Alashed/cubesat-wiki/docs/wiki/source/index.rst

.. CubeSat 1U Educational Kit documentation master file, created by
   sphinx-quickstart on Tue Apr 28 01:24:46 2026.
   You can adapt this file completely to your liking, but it should at least
   contain the root `toctree` directive.

Wiki образовательного набора CubeSat 1U
=======================================

Добро пожаловать в документацию по образовательному набору CubeSat 1U.
Этот проект помогает понять, как устроен малый спутник, как его собрать,
подключить и запрограммировать.

.. toctree::
   :maxdepth: 2
   :caption: Разделы

   what-is-cubesat
   kit-components
   assembly-guide
   wiring-diagram
   code-examples
   useful-links
