Alashed/cubesat-wiki/docs/wiki/source/useful-links.rst

Полезные ссылки
===============

В этом разделе собраны внешние материалы, которые могут пригодиться при
сборке, программировании и эксплуатации учебного CubeSat.

Схемы и сборка
--------------

- `Схема подключения CubeSat (Fritzing) на Google Drive
  <https://drive.google.com/drive/folders/1IPIubZdzvfppYFJH4a8wJ_4OlUEUYcYG?usp=sharing>`_
  — исходные файлы Fritzing, по которым построены схемы из инструкции
  по сборке.
