Alashed/cubesat-wiki/docs/wiki/source/_static/besprovodnoy-modul-nrf24l01-24-ggts-1.png

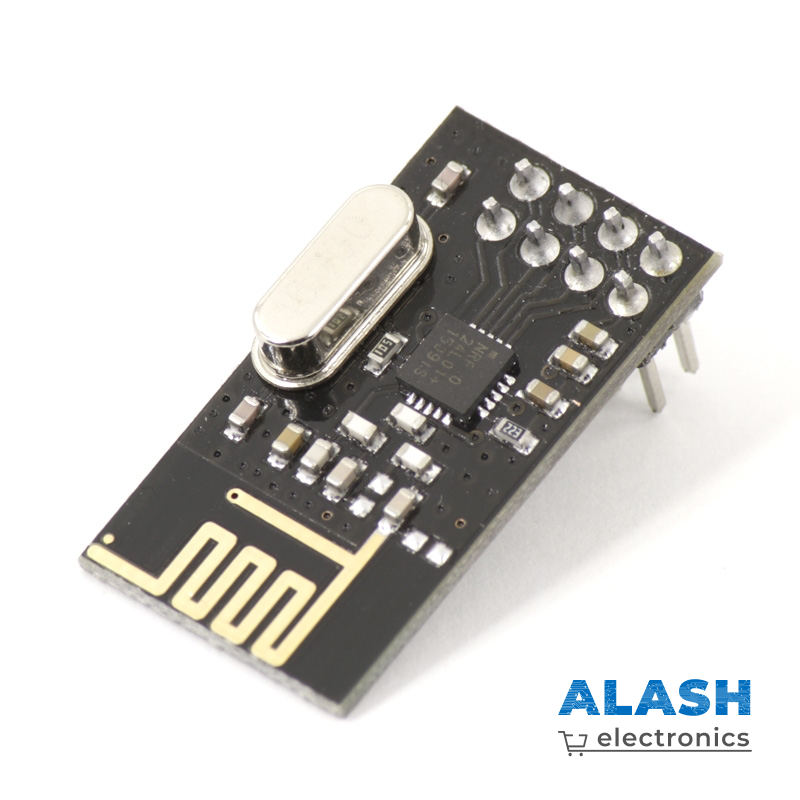
docs/wiki/source/_static/besprovodnoy-modul-nrf24l01-24-ggts-1.png
