Alashed/cubesat-wiki/docs/wiki/source/kit-components.rst

Состав набора CubeSat 1U
========================

На этой странице приведен полный состав образовательного набора в формате
таблицы для комплектации.

Таблица комплектации (изображение, название, количество)
--------------------------------------------------------

.. list-table::
   :header-rows: 1
   :widths: 30 55 15

   * - Изображение
     - Название компонента
     - Кол-во
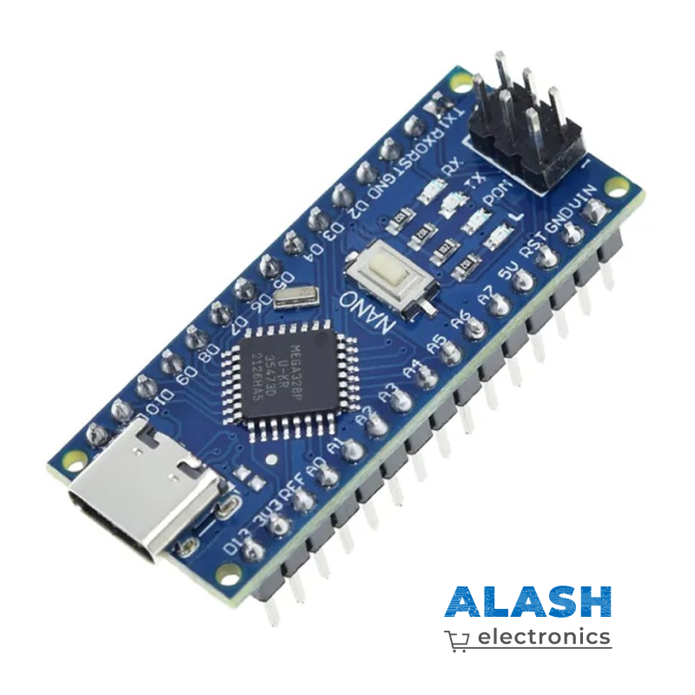
[picture p10: docs/wiki/source/_static/arduino-nano-v30-type-c-ch340-1.png]
Arduino Nano
   * - 
     - Микроконтроллер Arduino Nano
     - 1
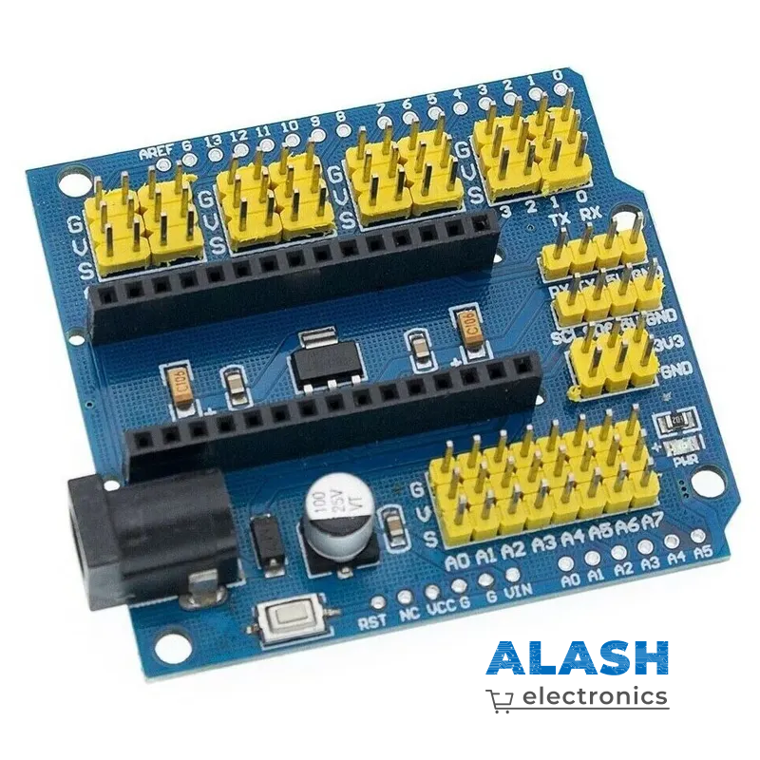
[picture p11: docs/wiki/source/_static/arduino-nano-shield-plata-rasshireniya-dlya-arduino-nano-1.png]
Arduino Nano Shield
   * - 
     - Плата расширения Arduino Nano Shield
     - 1
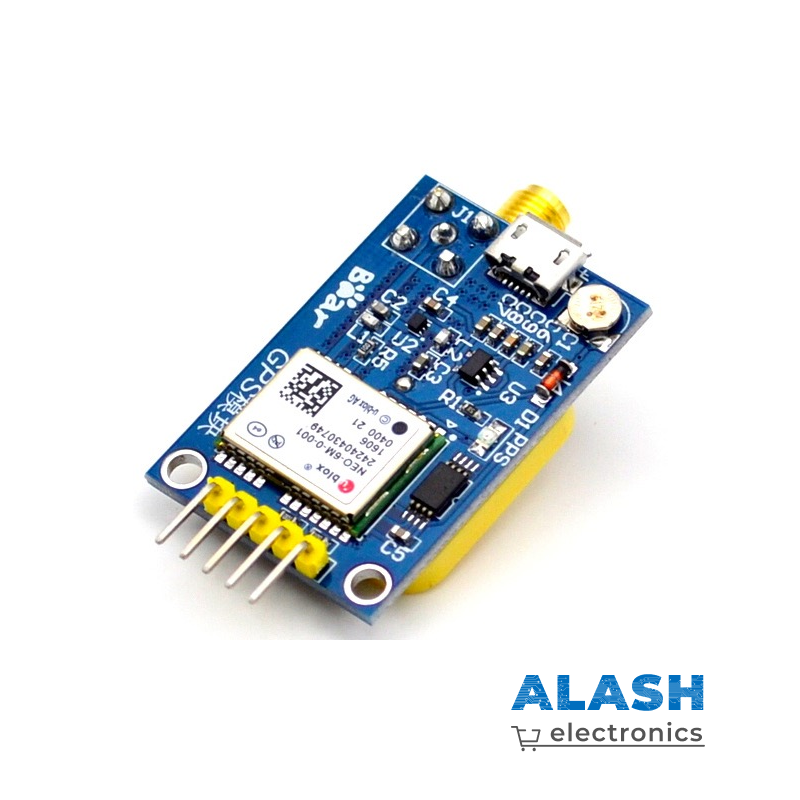
[picture p12: docs/wiki/source/_static/gps-modul-gy-neo-6m-sma-micro-usb-1.png]
GPS GY-NEO-6M
   * - 
     - GPS-модуль GY-NEO-6M (SMA, micro USB)
     - 1
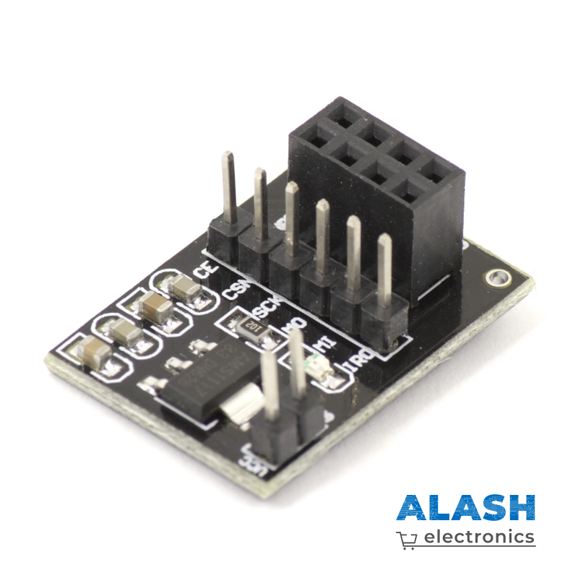
[picture p13: docs/wiki/source/_static/perehodnik-dlya-nrf24l01-33-v-1.png]
Питание для nRF24L01+
   * - 
     - Внешний модуль питания для nRF24L01+
     - 2
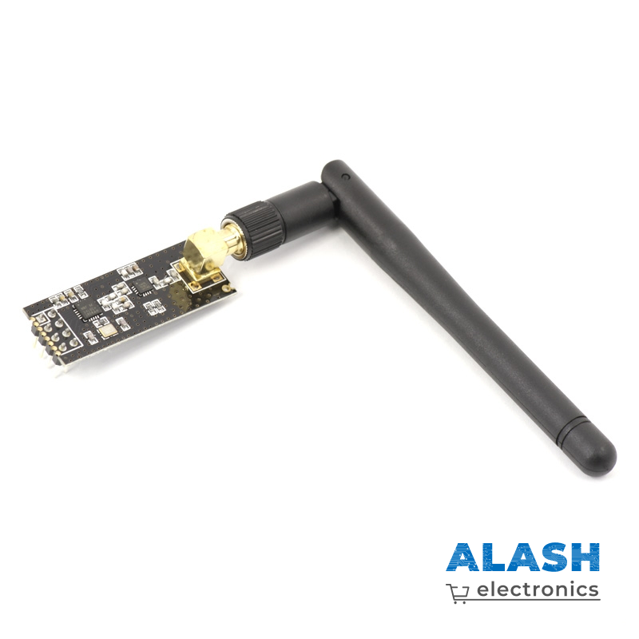
[picture p14: docs/wiki/source/_static/besprovodnoy-modul-nrf24l01palna-s-vneshney-sma-antennoy-1.png]
nRF24L01+ с антенной
   * - 
     - nRF24L01+ с антенной
     - 1
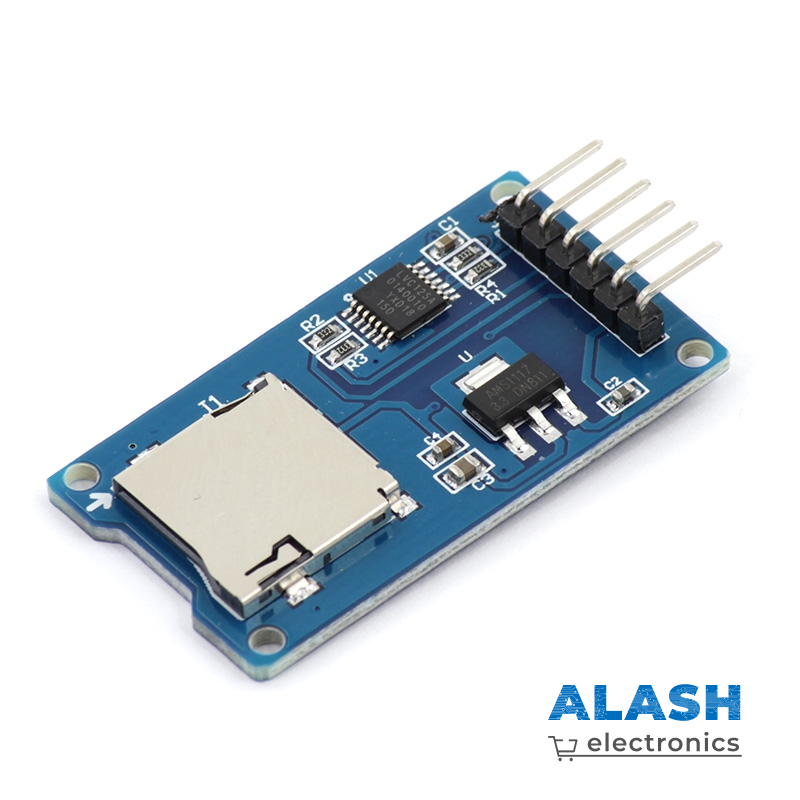
[picture p15: docs/wiki/source/_static/modul-kartrider-karty-pamyati-micro-sd-1.png]
SD модуль
   * - 
     - Модуль microSD (SD Card Module SPI)
     - 1
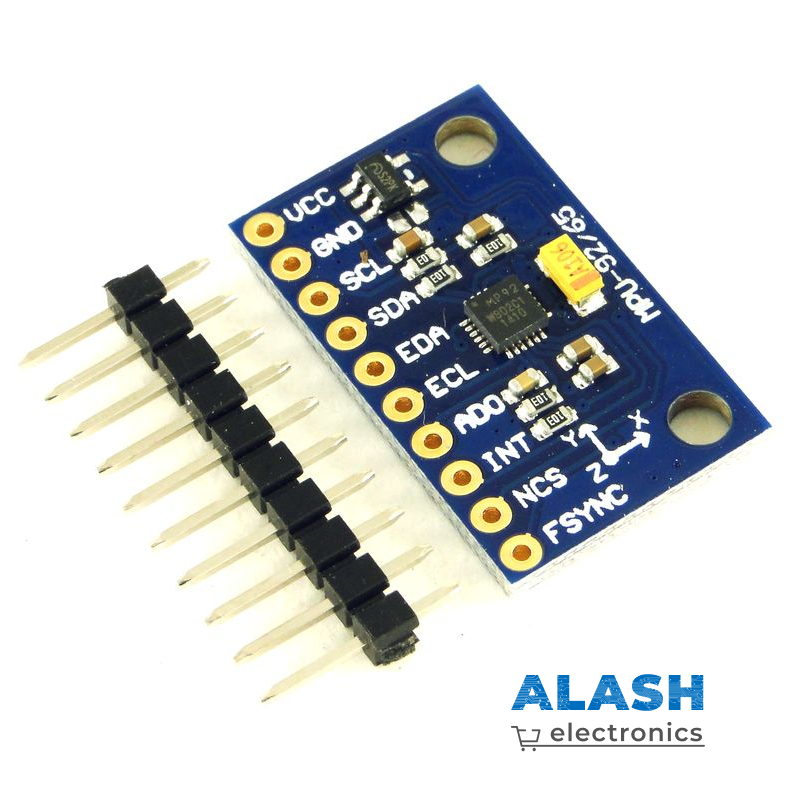
[picture p16: docs/wiki/source/_static/9-osevoy-datchik-mpu-9250-elektronnyy-kompas-akselerometr-giroskop-1.png]
MPU9250
   * - 
     - IMU-модуль MPU9250
     - 1
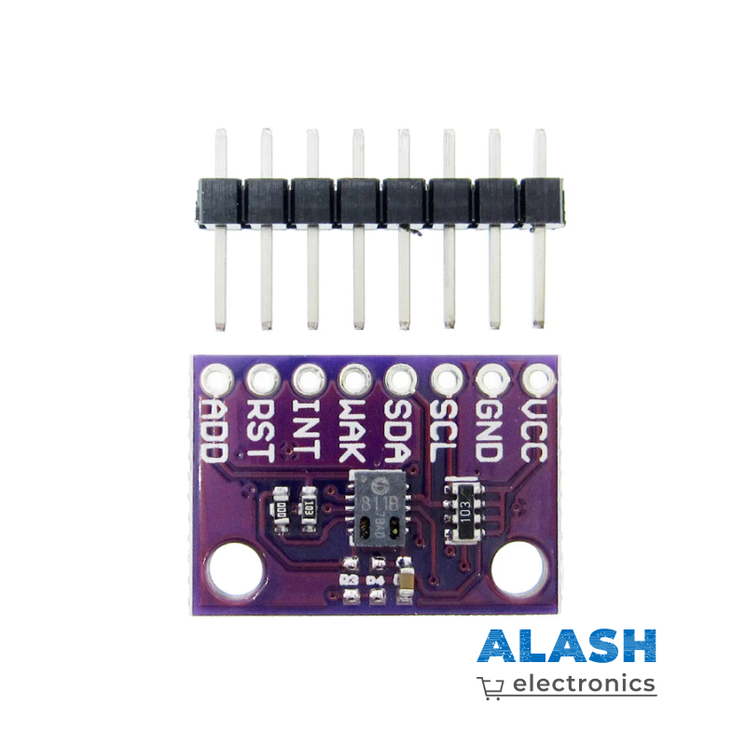
[picture p17: docs/wiki/source/_static/datchik-modul-datchika-obnaruzheniya-uglekislogo-gaza-ccs811-modul-co2-eco2-tvoc-opredelenie-kachestva-vozduha-vyhod-i2c-cjmcu-811-1.png]
CCS811
   * - 
     - Датчик газа CCS811
     - 1
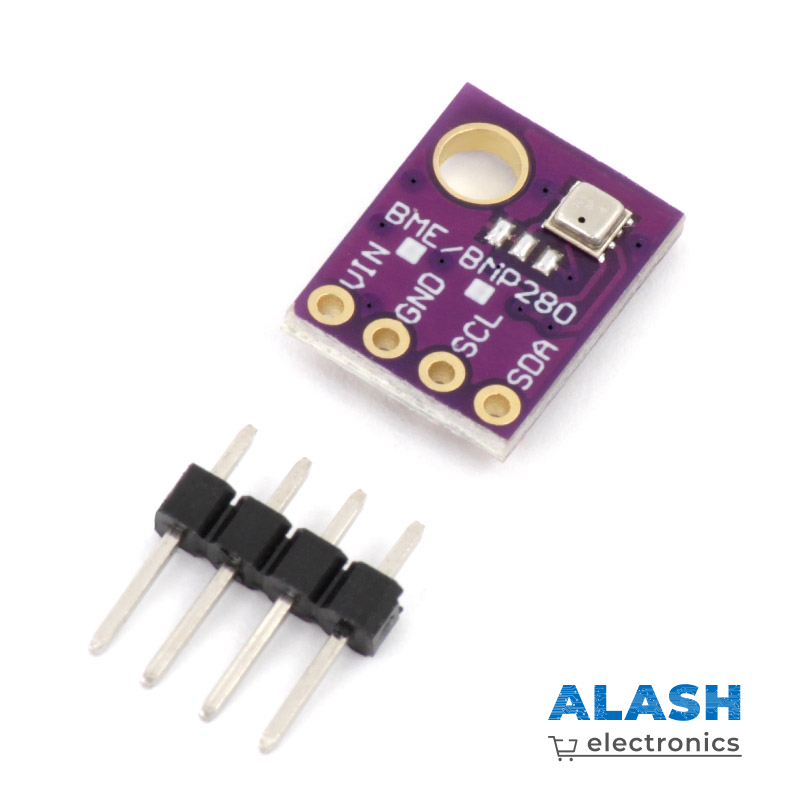
[picture p18: docs/wiki/source/_static/datchik-temperatury-vlazhnosti-i-davleniya-bme280-2.png]
BME280
   * - 
     - Барометрический датчик BME280
     - 1
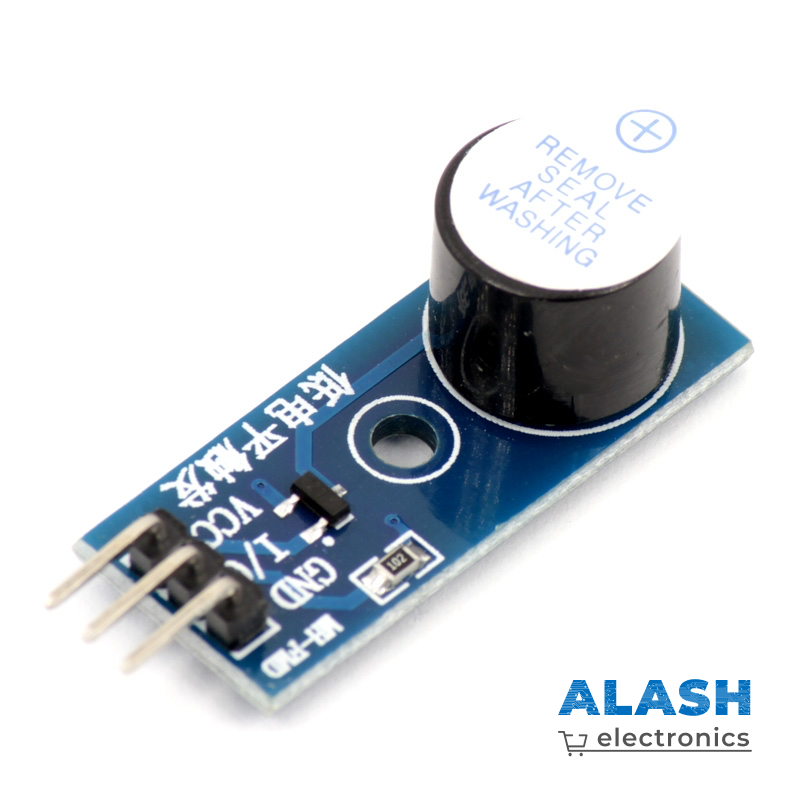
[picture p19: docs/wiki/source/_static/modul-aktivnogo-zummera-1.png]
Buzzer
   * - 
     - Звуковой модуль (Buzzer Module)
     - 1
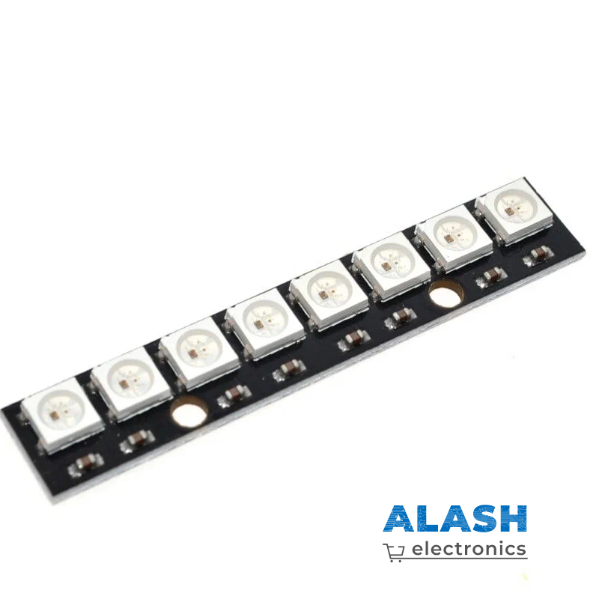
[picture p20: docs/wiki/source/_static/poloska-rgb-svetodiodov-ws2812b-8-sht-1.png]
LED лента
   * - 
     - Адресная LED-лента
     - 1
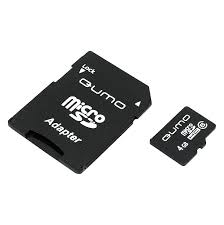
[picture p21: docs/wiki/source/_static/sd-card.jpeg]
Карта microSD
   * - 
     - Карта памяти microSD
     - 1
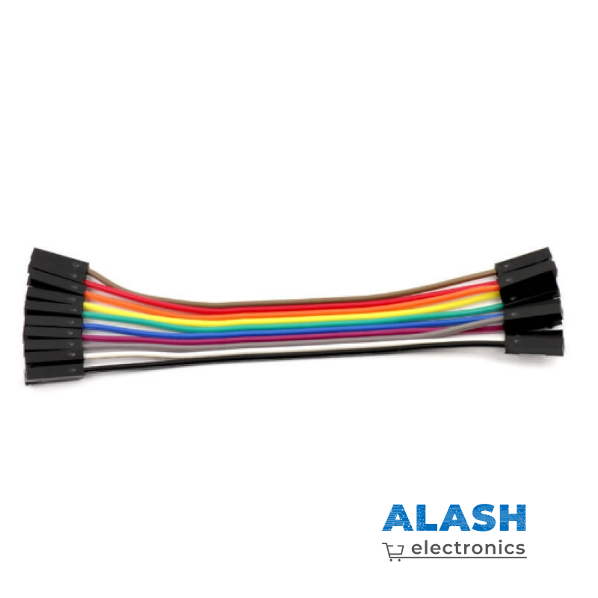
[picture p22: docs/wiki/source/_static/soedinitelnye-provoda-mama-mama-10-sm-10-sht-1.png]
Соединительные провода
   * - 
     - Соединительные провода Dupont / монтажные провода
     - 20+
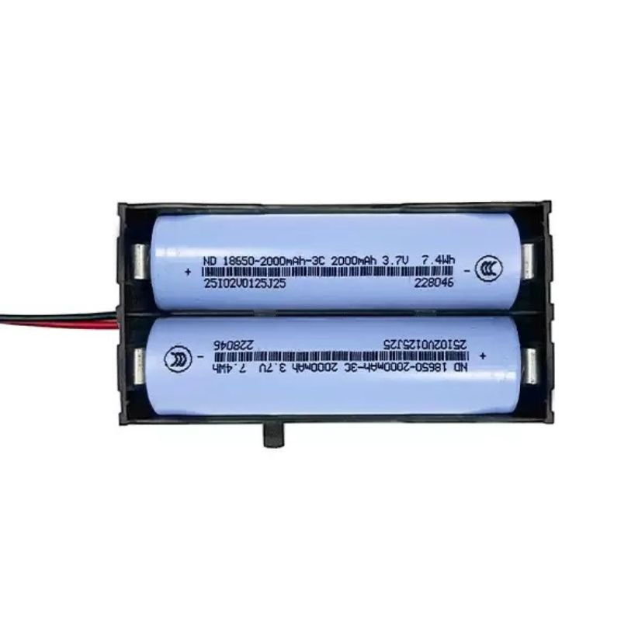
[picture p23: docs/wiki/source/_static/power-source.jpg]
Источник питания
   * - 
     - Источник питания (батарейный блок)
     - 1
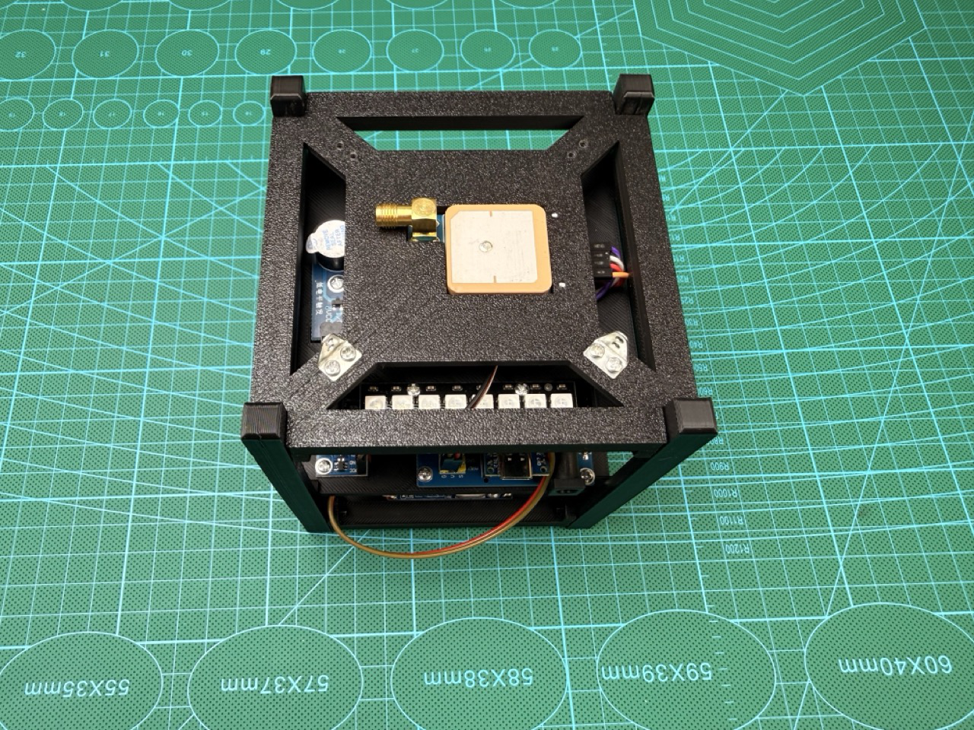
[picture p24: docs/wiki/source/_static/50.jpeg]
Корпус CubeSat 1U
   * - 
     - 3D-печатный корпус 1U CubeSat
     - 1
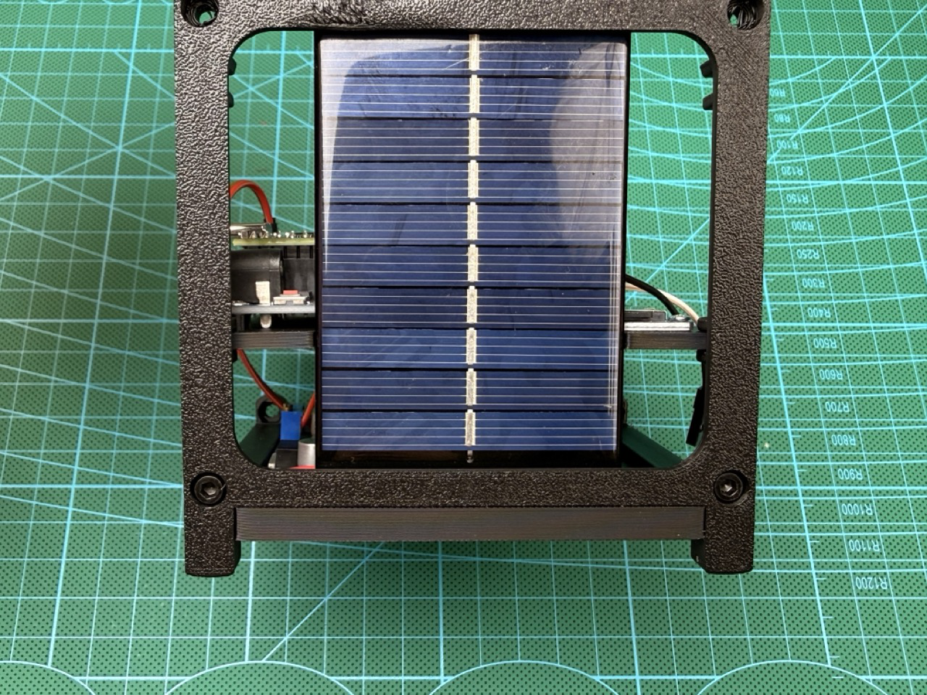
[picture p25: docs/wiki/source/_static/24.jpeg]
Солнечная панель
   * - 
     - Солнечная панель
     - 2
