Alashed/cubesat-wiki/docs/wiki/source/assembly-guide.rst

Инструкция по сборке CubeSat
============================

Перед началом
-------------

1. Проверьте комплектность всех модулей и крепежа.
2. Подготовьте рабочее место без статического электричества.
3. Убедитесь, что питание отключено перед монтажом.

Шаги сборки
-----------

1. Соберите механический каркас 1U.
2. Установите модуль питания и аккумулятор.
3. Закрепите бортовой компьютер и интерфейсные платы.
4. Подключите датчики и модуль связи.
5. Проверьте полярность и надежность всех соединений.
6. Выполните первое включение в безопасном режиме.

Фото-инструкция по сборке (шаги 1-51)
-------------------------------------

.. note::

   Перед физическими шагами 26, 35 и 44 добавлены схемы подключения. На них
   для удобства показаны **только те компоненты, которые подключаются по
   текущему и ближайшим шагам инструкции**, без уже смонтированных ранее
   модулей. Это помогает не запутаться в проводах.

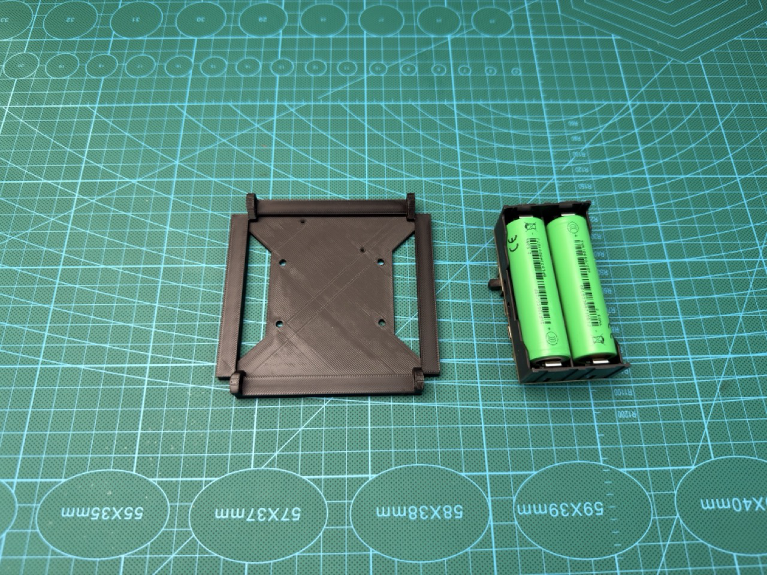
[picture p28: docs/wiki/source/_static/1.jpeg]
Шаг сборки 1


   Шаг 1.

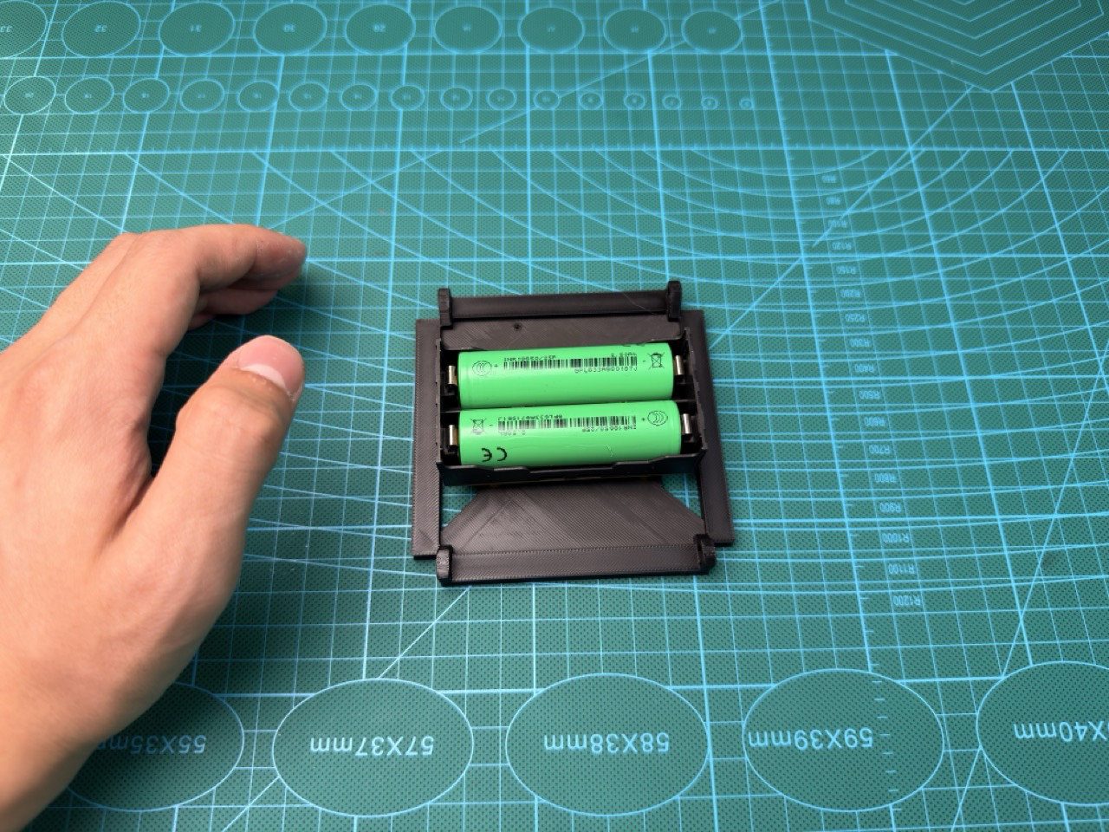
[picture p29: docs/wiki/source/_static/2.jpeg]
Шаг сборки 2


   Шаг 2.

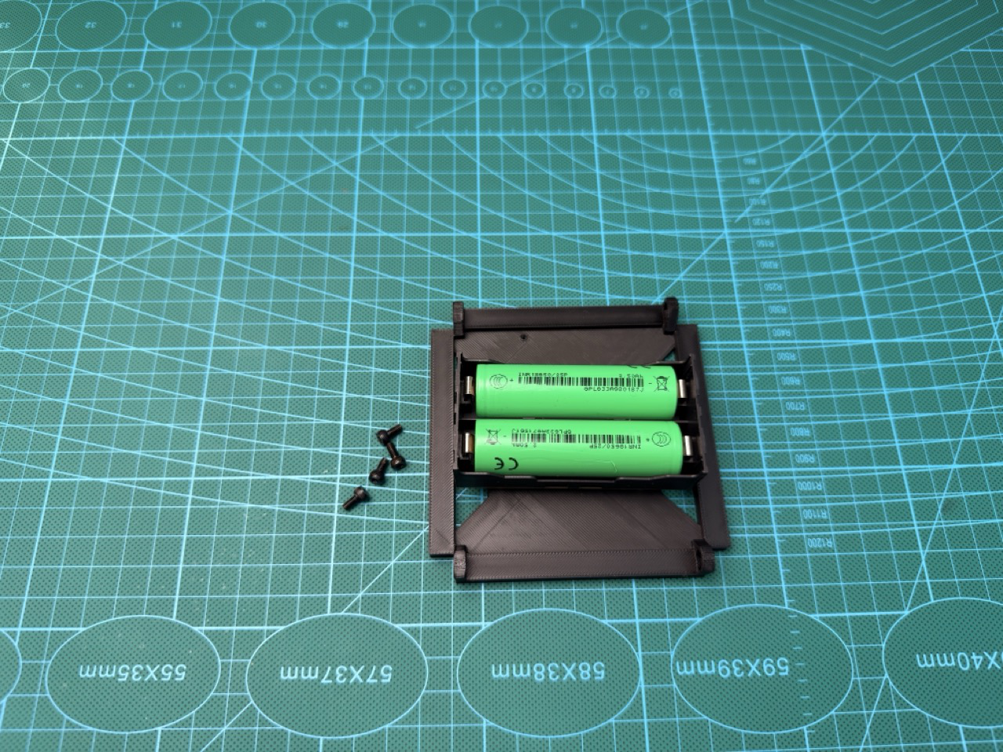
[picture p30: docs/wiki/source/_static/3.jpeg]
Шаг сборки 3


   Шаг 3.

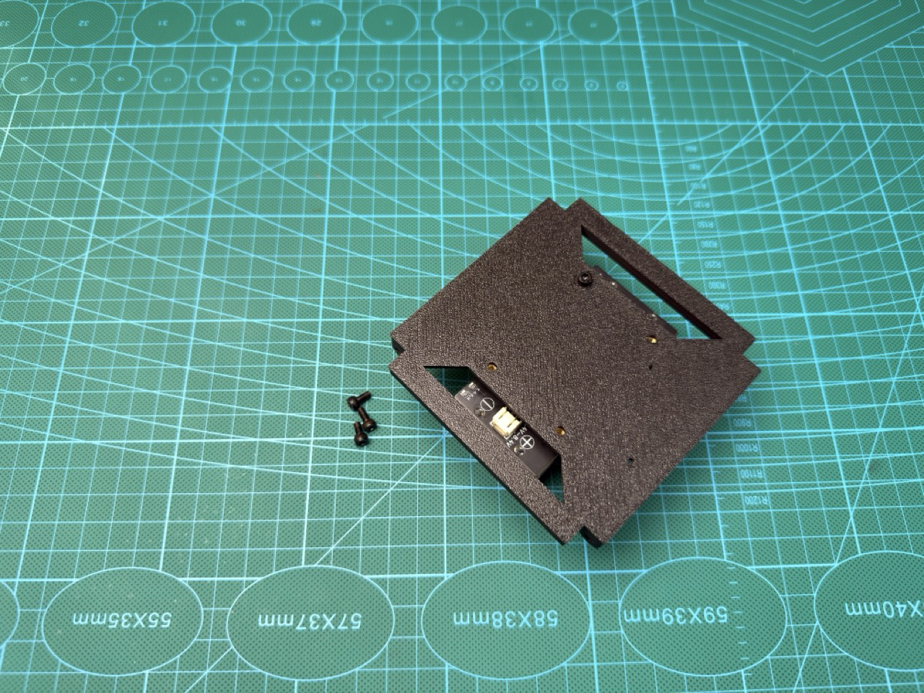
[picture p31: docs/wiki/source/_static/4.jpeg]
Шаг сборки 4


   Шаг 4.

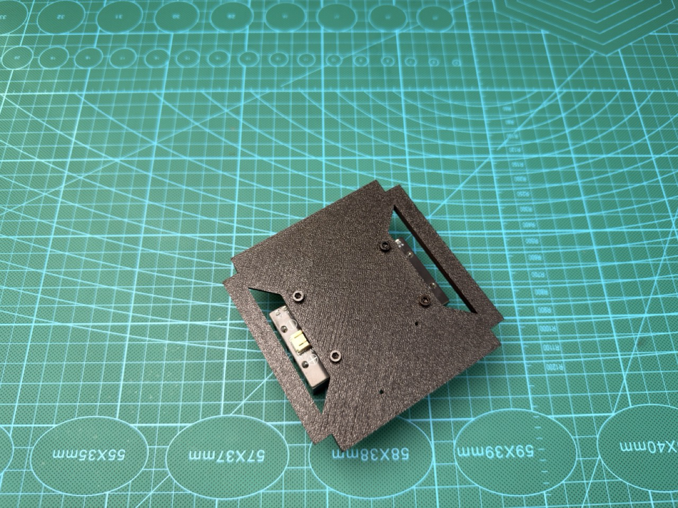
[picture p32: docs/wiki/source/_static/5.jpeg]
Шаг сборки 5


   Шаг 5.

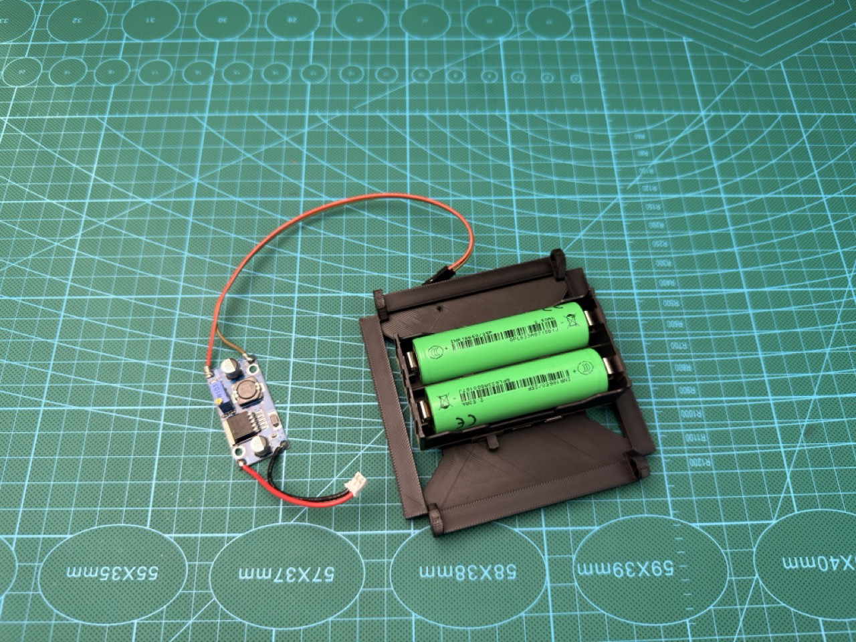
[picture p33: docs/wiki/source/_static/6.jpeg]
Шаг сборки 6


   Шаг 6.

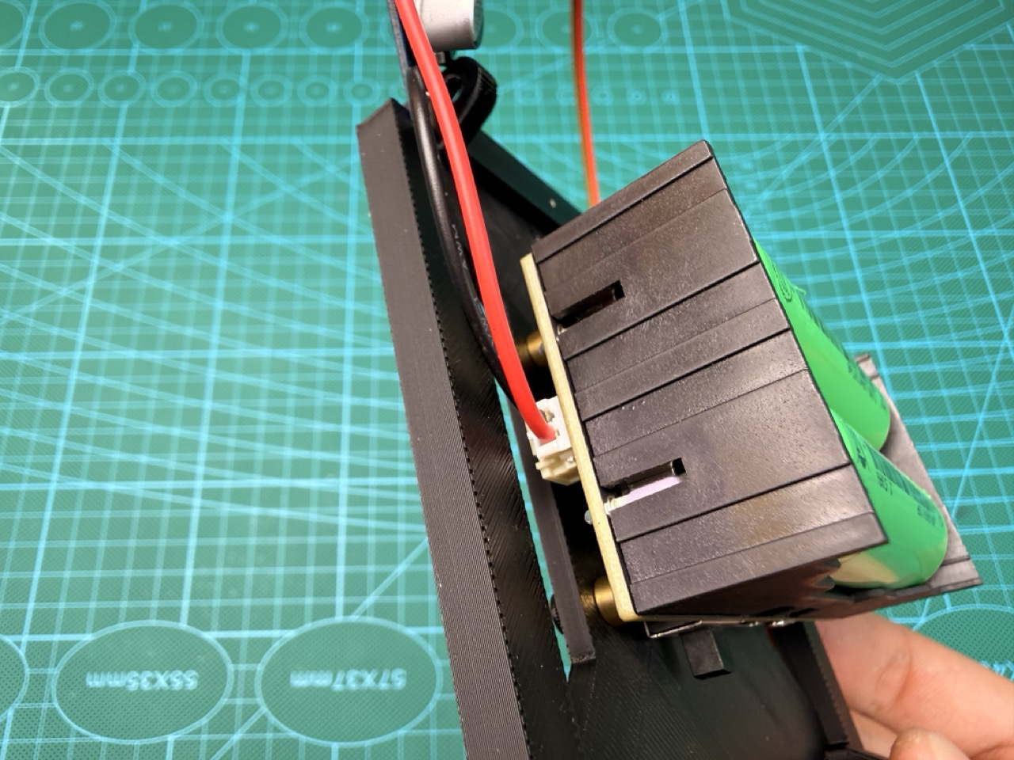
[picture p34: docs/wiki/source/_static/7.jpeg]
Шаг сборки 7


   Шаг 7.

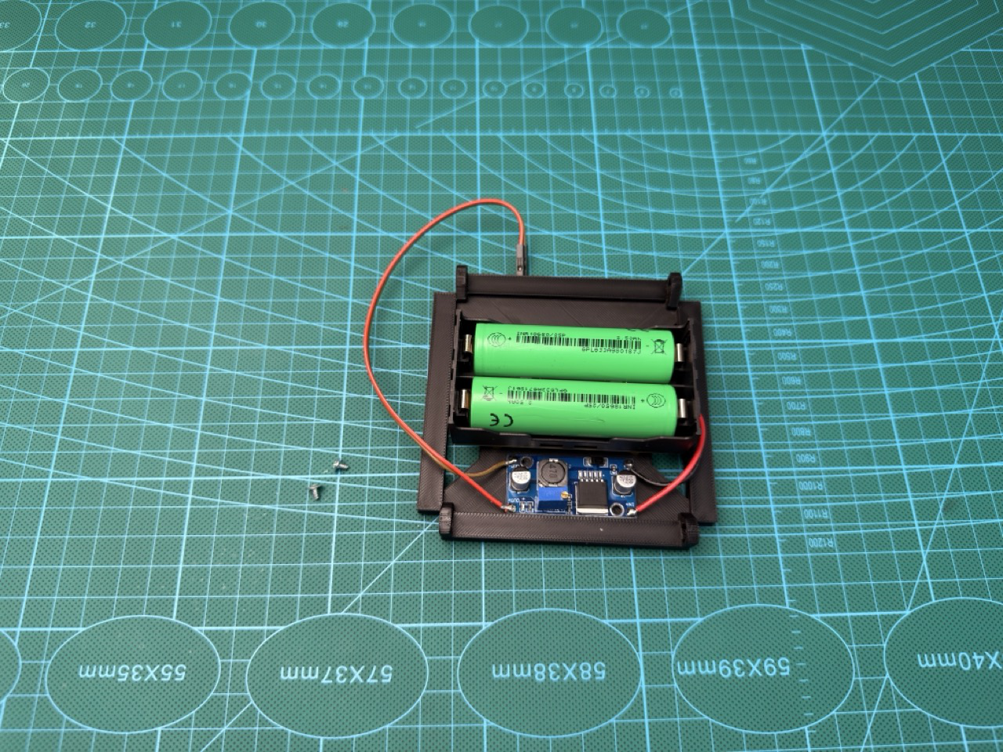
[picture p35: docs/wiki/source/_static/8.jpeg]
Шаг сборки 8


   Шаг 8.

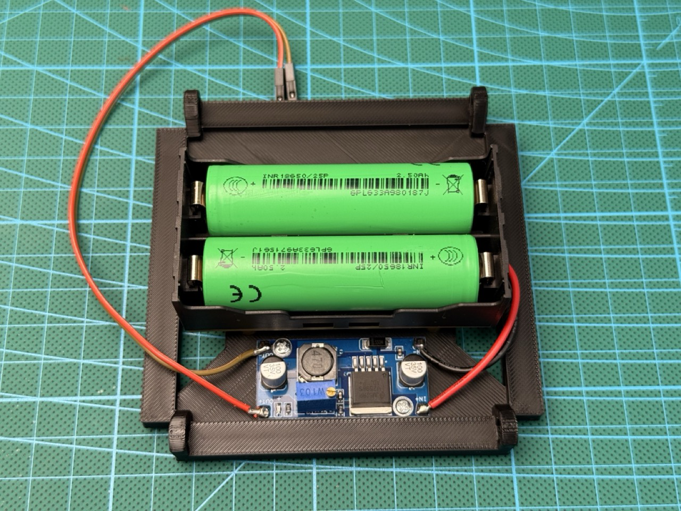
[picture p36: docs/wiki/source/_static/9.jpeg]
Шаг сборки 9


   Шаг 9.

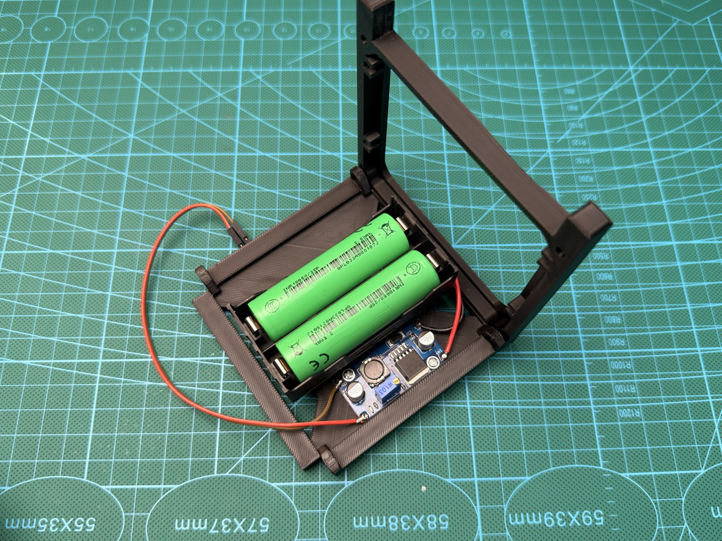
[picture p37: docs/wiki/source/_static/10.jpeg]
Шаг сборки 10


   Шаг 10.

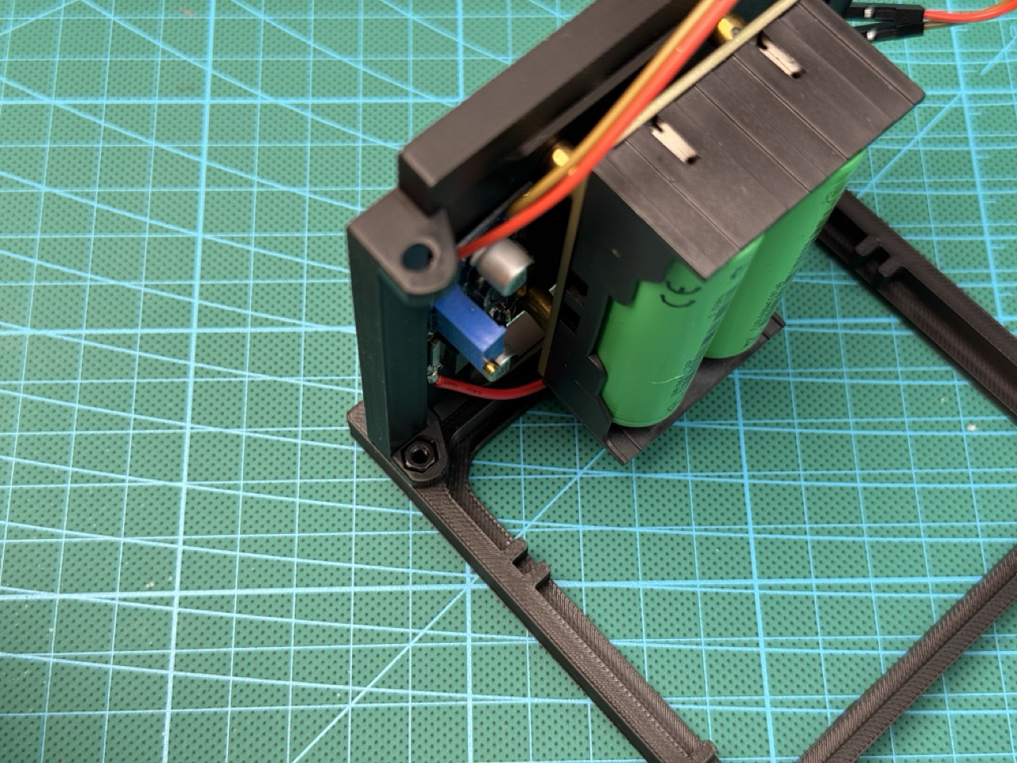
[picture p38: docs/wiki/source/_static/11.jpeg]
Шаг сборки 11


   Шаг 11.

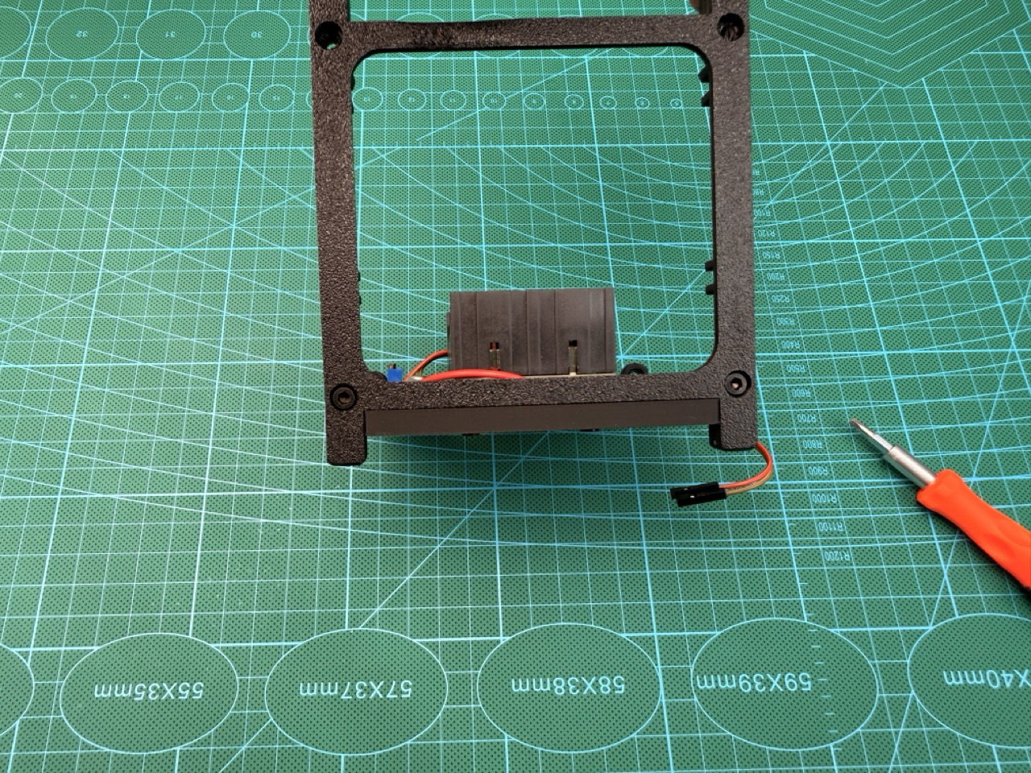
[picture p39: docs/wiki/source/_static/12.jpeg]
Шаг сборки 12


   Шаг 12.

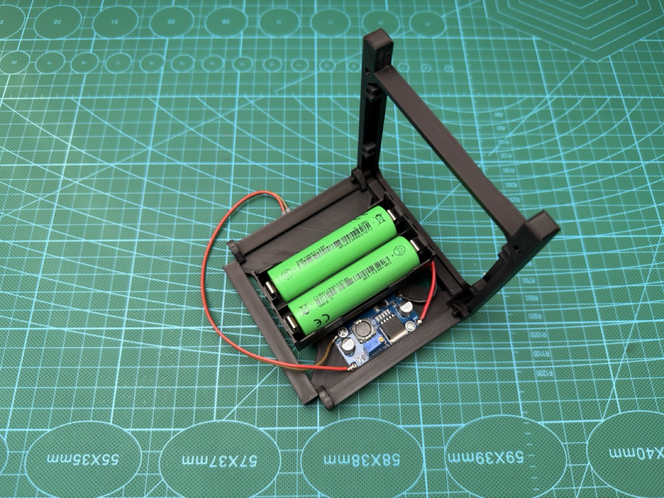
[picture p40: docs/wiki/source/_static/13.jpeg]
Шаг сборки 13


   Шаг 13.

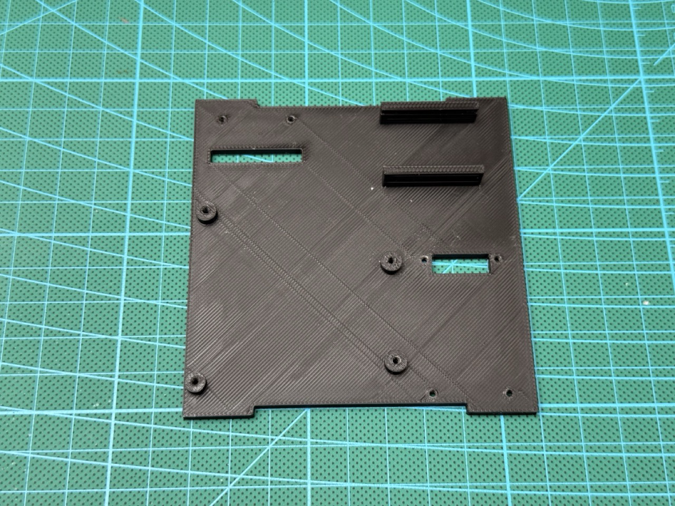
[picture p41: docs/wiki/source/_static/14.jpeg]
Шаг сборки 14


   Шаг 14.

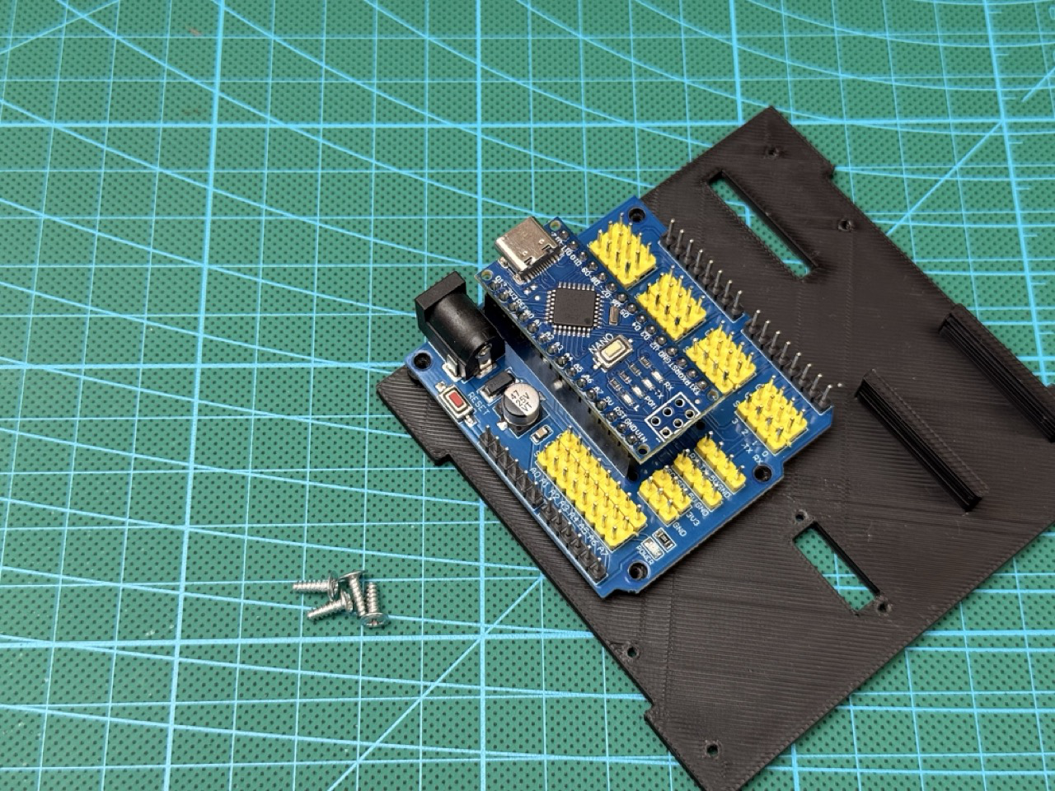
[picture p42: docs/wiki/source/_static/15.jpeg]
Шаг сборки 15


   Шаг 15.

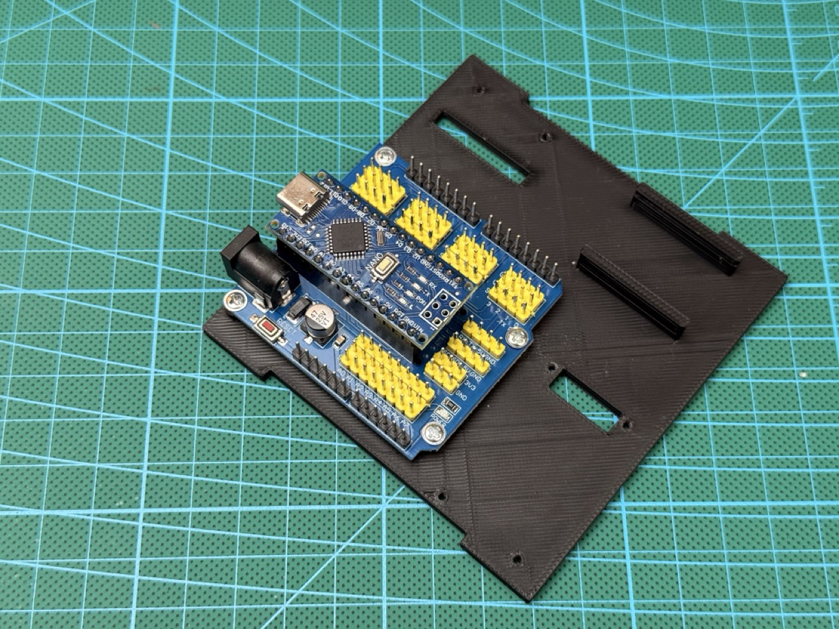
[picture p43: docs/wiki/source/_static/16.jpeg]
Шаг сборки 16


   Шаг 16.

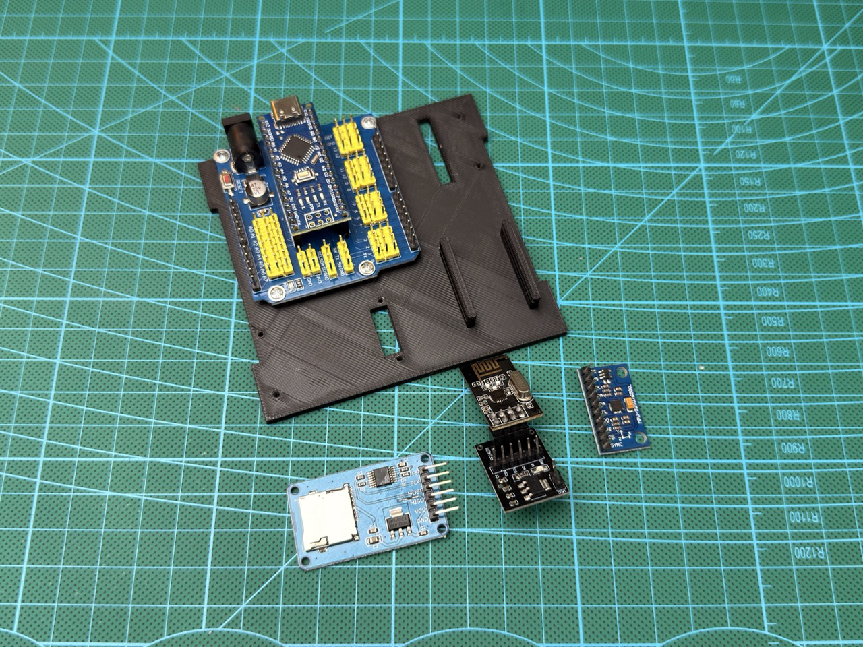
[picture p44: docs/wiki/source/_static/17.jpeg]
Шаг сборки 17


   Шаг 17.

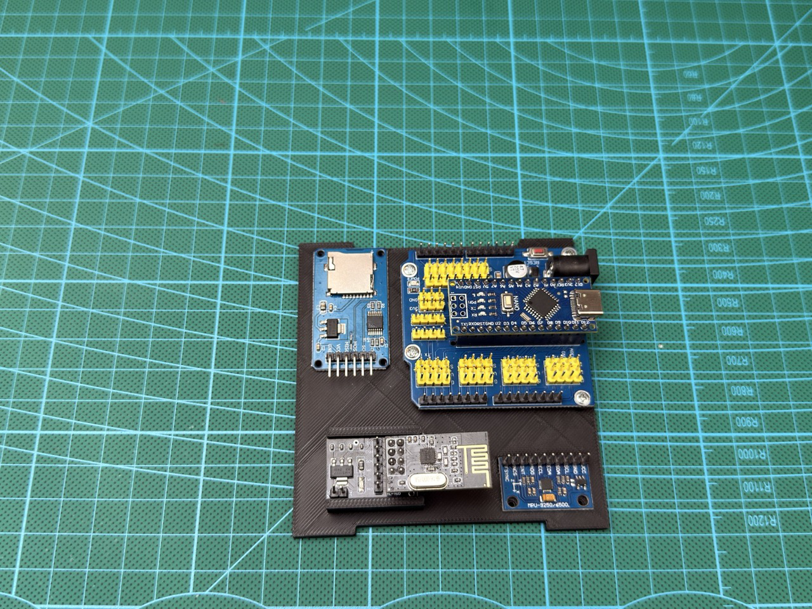
[picture p45: docs/wiki/source/_static/18.jpeg]
Шаг сборки 18


   Шаг 18.

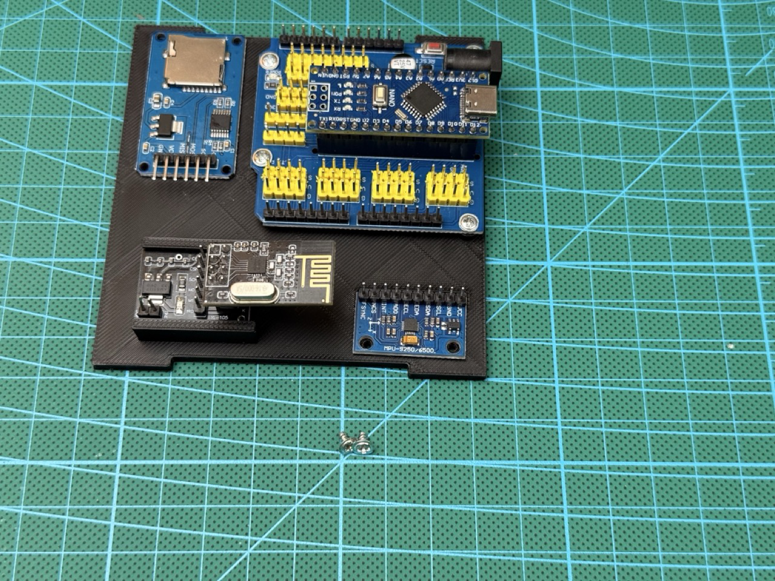
[picture p46: docs/wiki/source/_static/19.jpeg]
Шаг сборки 19


   Шаг 19.

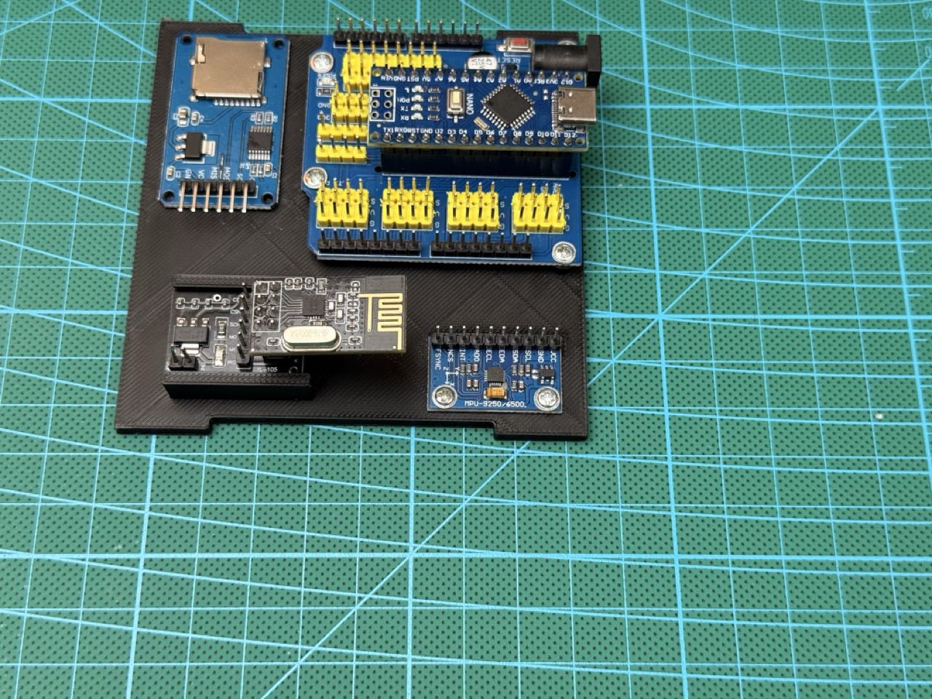
[picture p47: docs/wiki/source/_static/20.jpeg]
Шаг сборки 20


   Шаг 20.

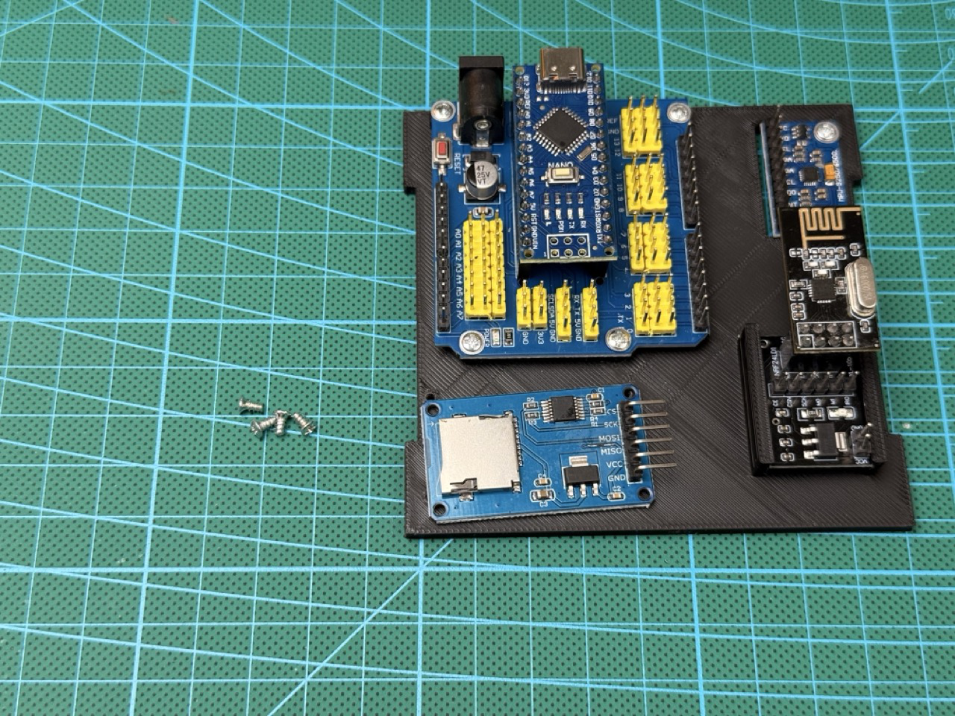
[picture p48: docs/wiki/source/_static/21.jpeg]
Шаг сборки 21


   Шаг 21.

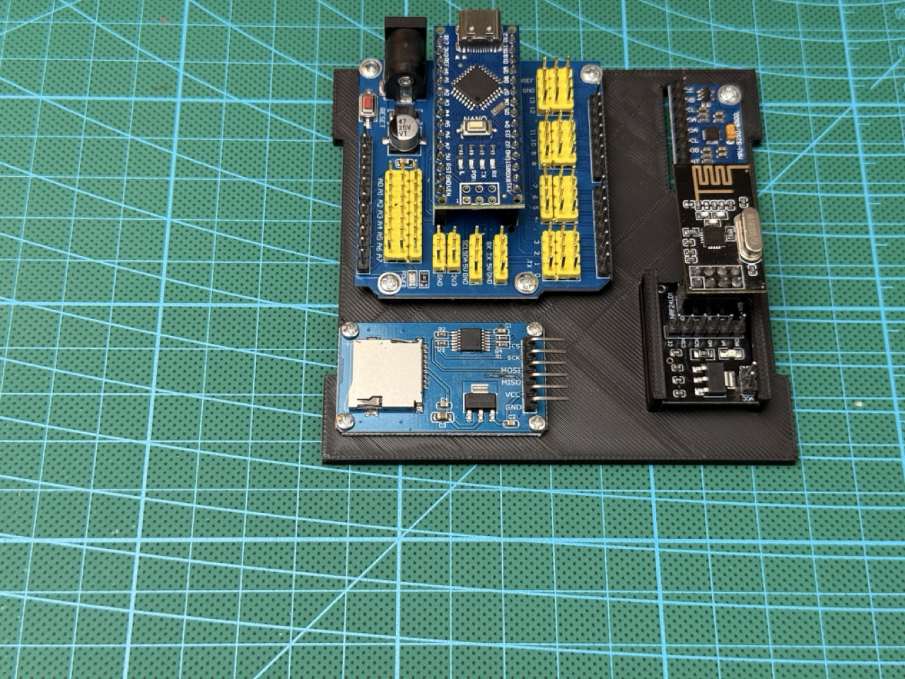
[picture p49: docs/wiki/source/_static/22.jpeg]
Шаг сборки 22


   Шаг 22.

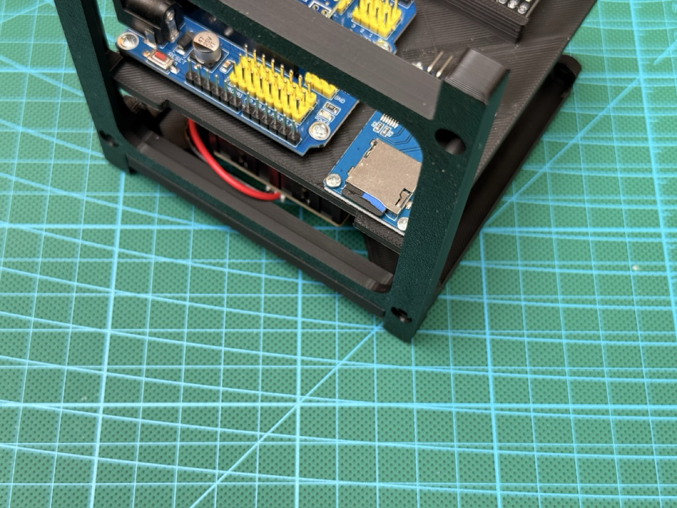
[picture p50: docs/wiki/source/_static/23.jpeg]
Шаг сборки 23


   Шаг 23.

Шаг сборки 24

   Шаг 24.

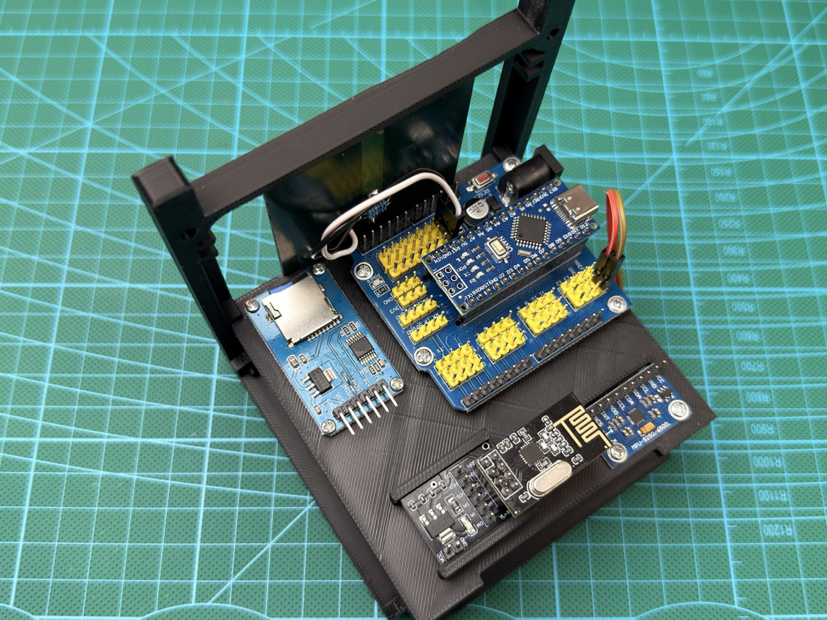
[picture p51: docs/wiki/source/_static/25.jpeg]
Шаг сборки 25


   Шаг 25.

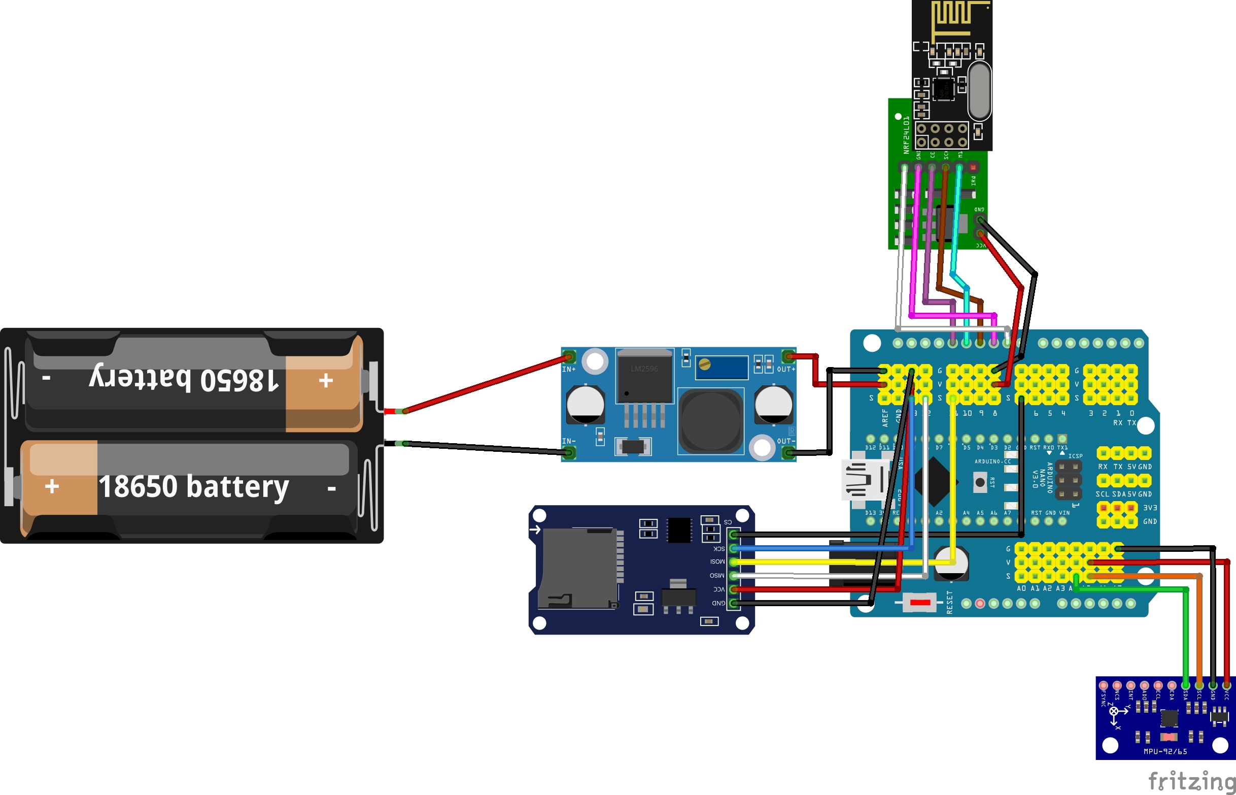
[picture p52: docs/wiki/source/_static/CubeSat-scheme-step-26.jpg]
Шаг сборки 26 — схема подключения


   Шаг 26. Схема подключения модулей (см. примечание выше).

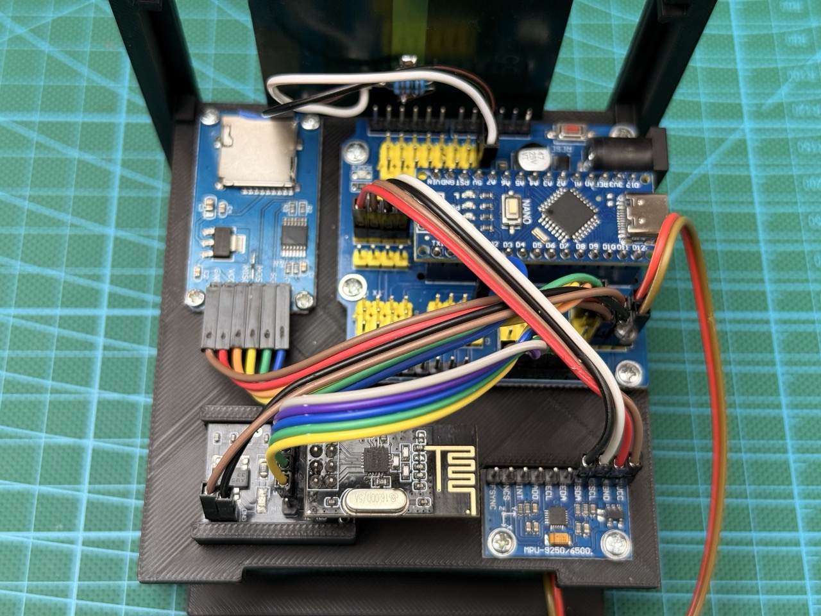
[picture p53: docs/wiki/source/_static/27.jpeg]
Шаг сборки 27


   Шаг 27.

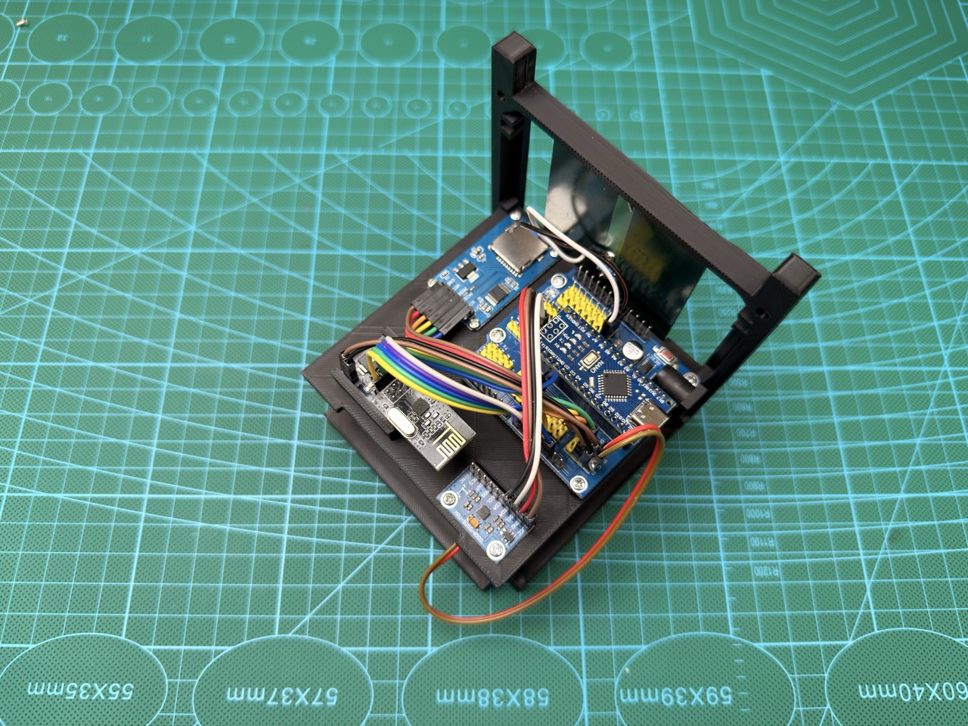
[picture p54: docs/wiki/source/_static/28.jpeg]
Шаг сборки 28


   Шаг 28.

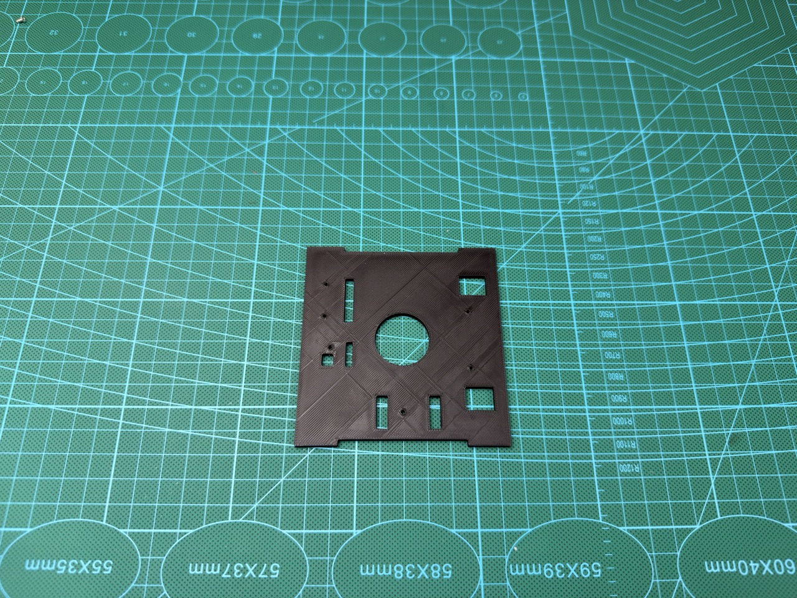
[picture p55: docs/wiki/source/_static/29.jpeg]
Шаг сборки 29


   Шаг 29.

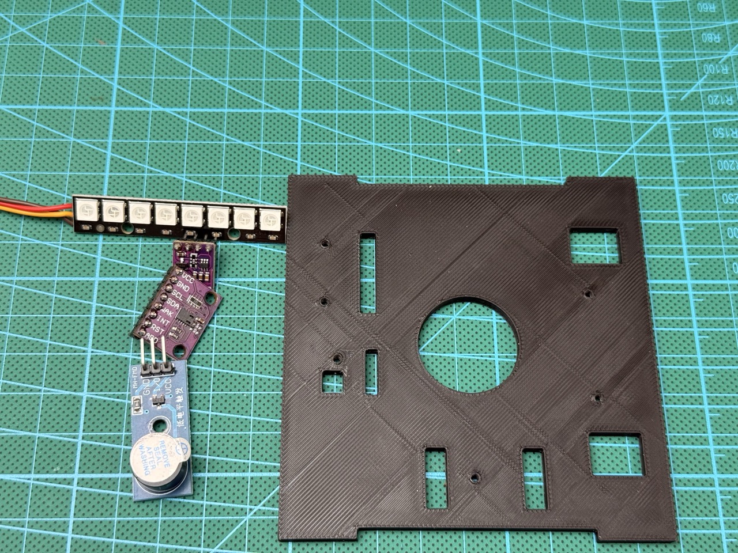
[picture p56: docs/wiki/source/_static/30.jpeg]
Шаг сборки 30


   Шаг 30.

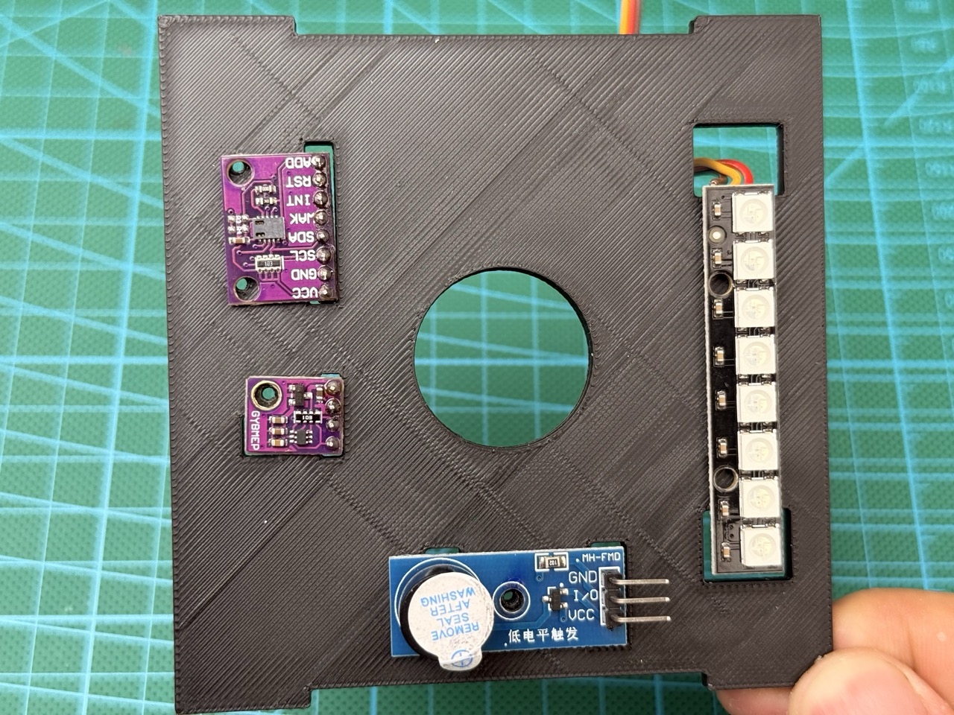
[picture p57: docs/wiki/source/_static/31.jpeg]
Шаг сборки 31


   Шаг 31.

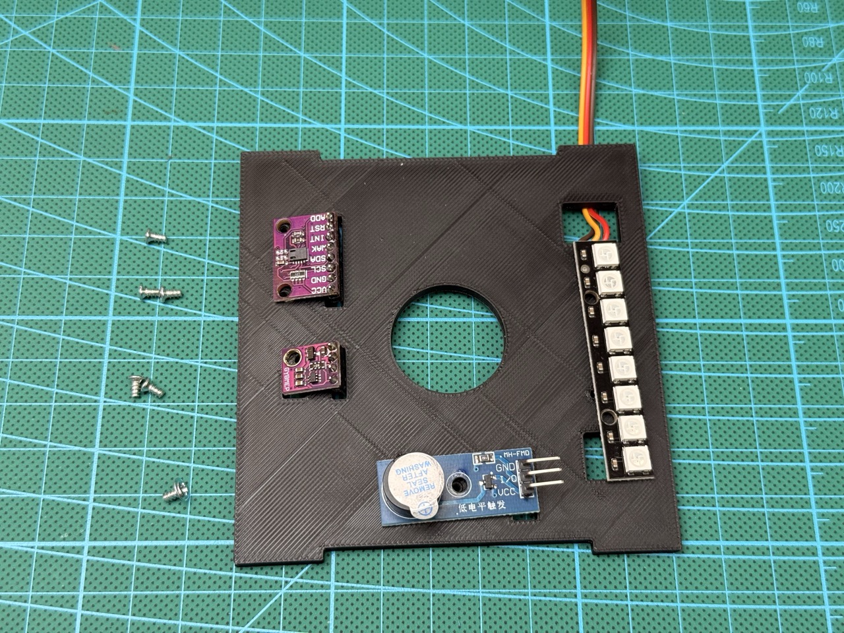
[picture p58: docs/wiki/source/_static/32.jpeg]
Шаг сборки 32


   Шаг 32.

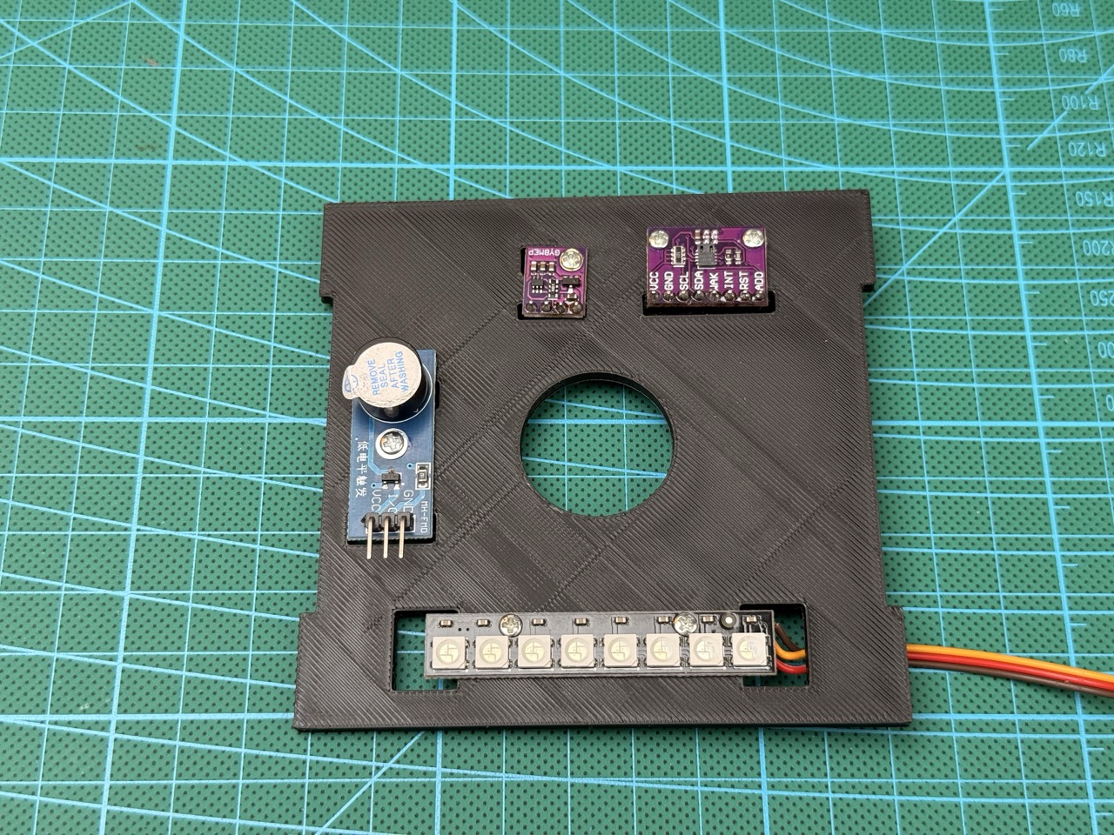
[picture p59: docs/wiki/source/_static/33.jpeg]
Шаг сборки 33


   Шаг 33.

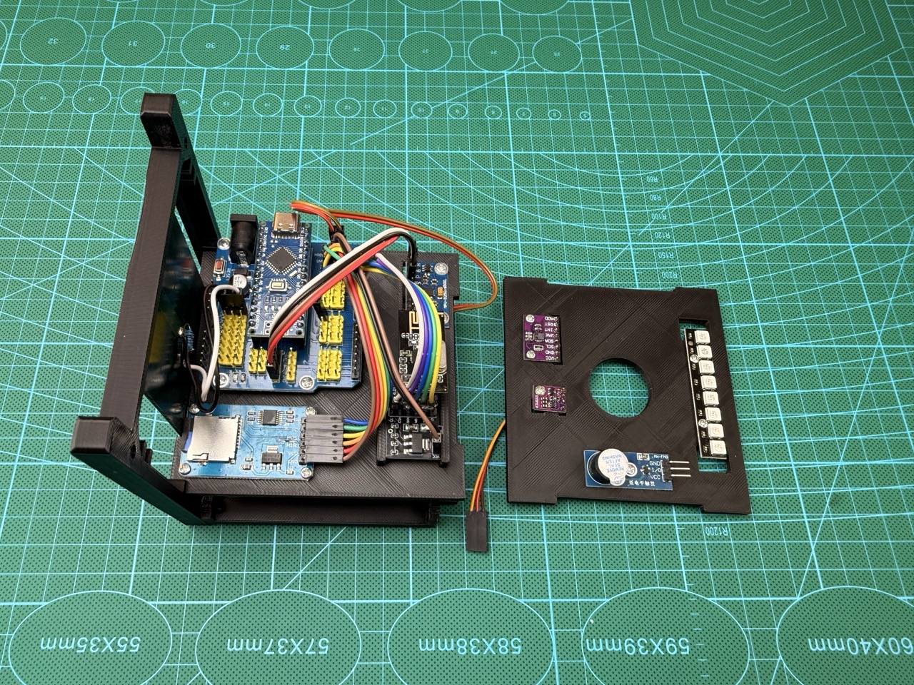
[picture p60: docs/wiki/source/_static/34.jpeg]
Шаг сборки 34


   Шаг 34.

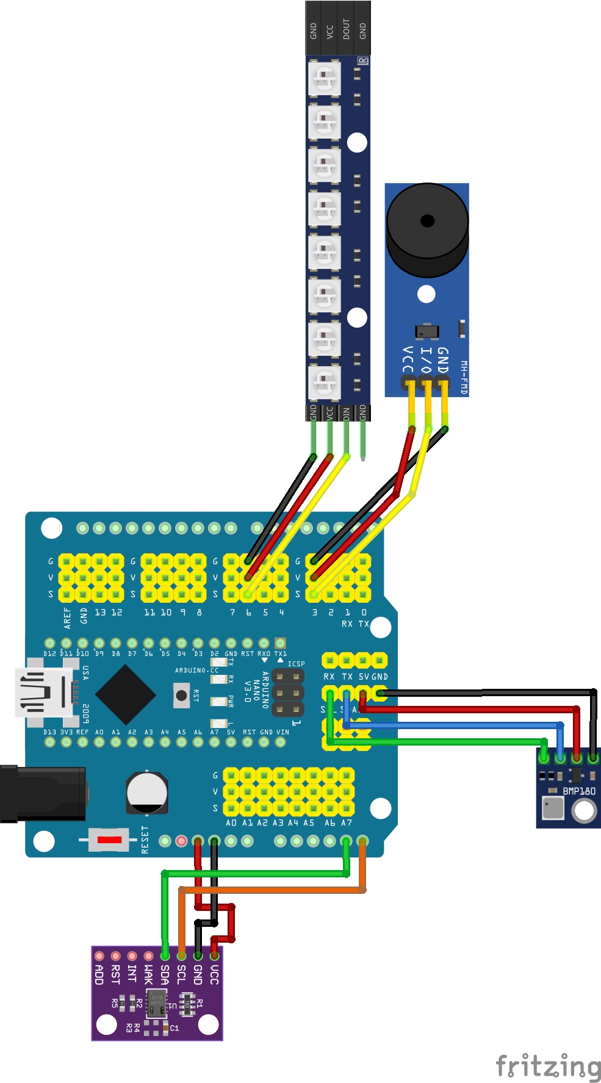
[picture p61: docs/wiki/source/_static/CubeSat-scheme-step-35.jpg]
Шаг сборки 35 — схема подключения


   Шаг 35. Схема подключения модулей (см. примечание выше).

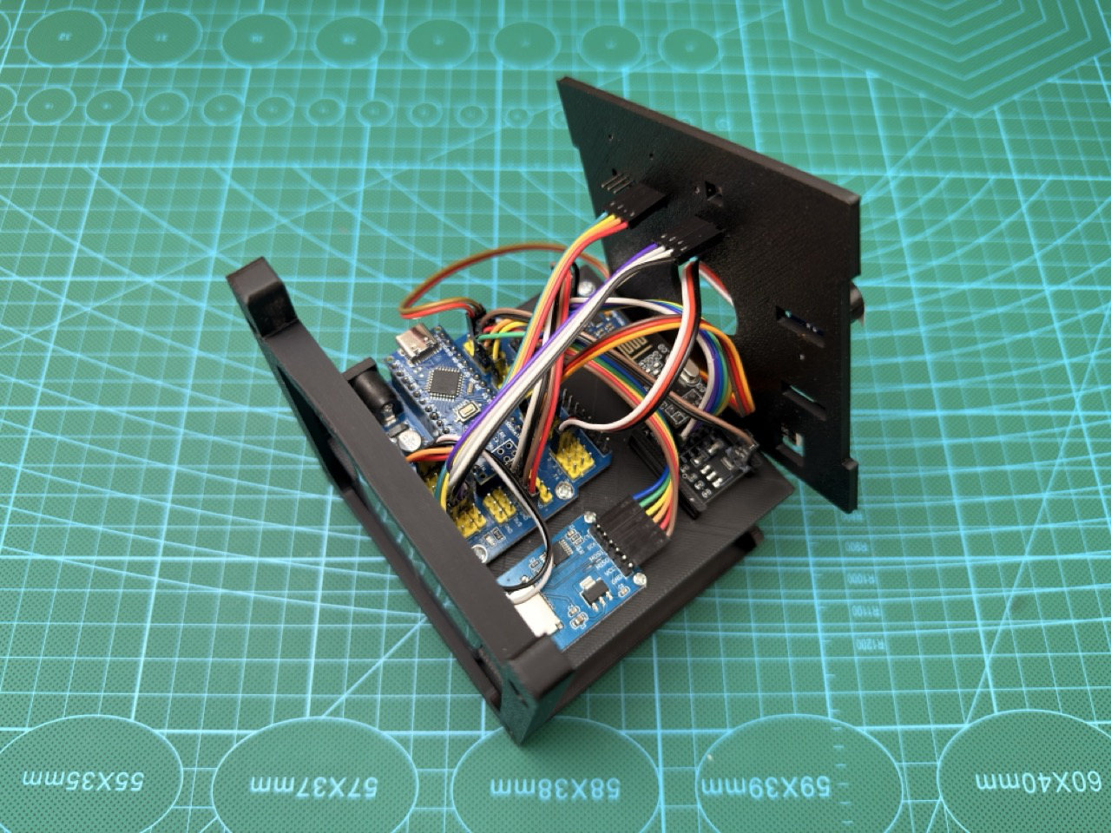
[picture p62: docs/wiki/source/_static/36.jpeg]
Шаг сборки 36


   Шаг 36.

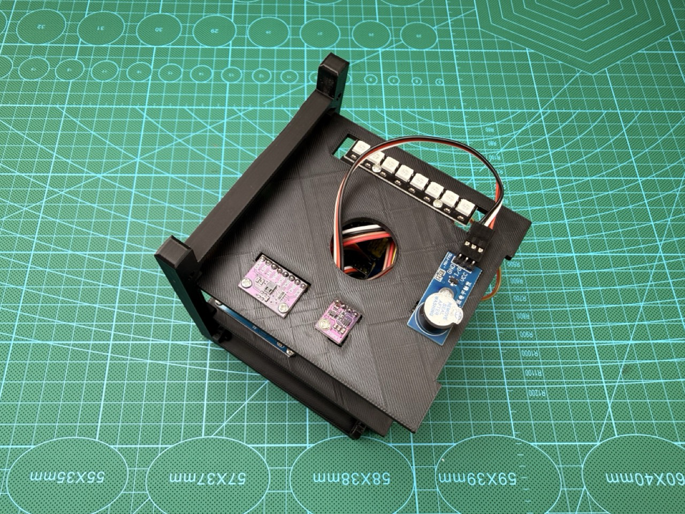
[picture p63: docs/wiki/source/_static/37.jpeg]
Шаг сборки 37


   Шаг 37.

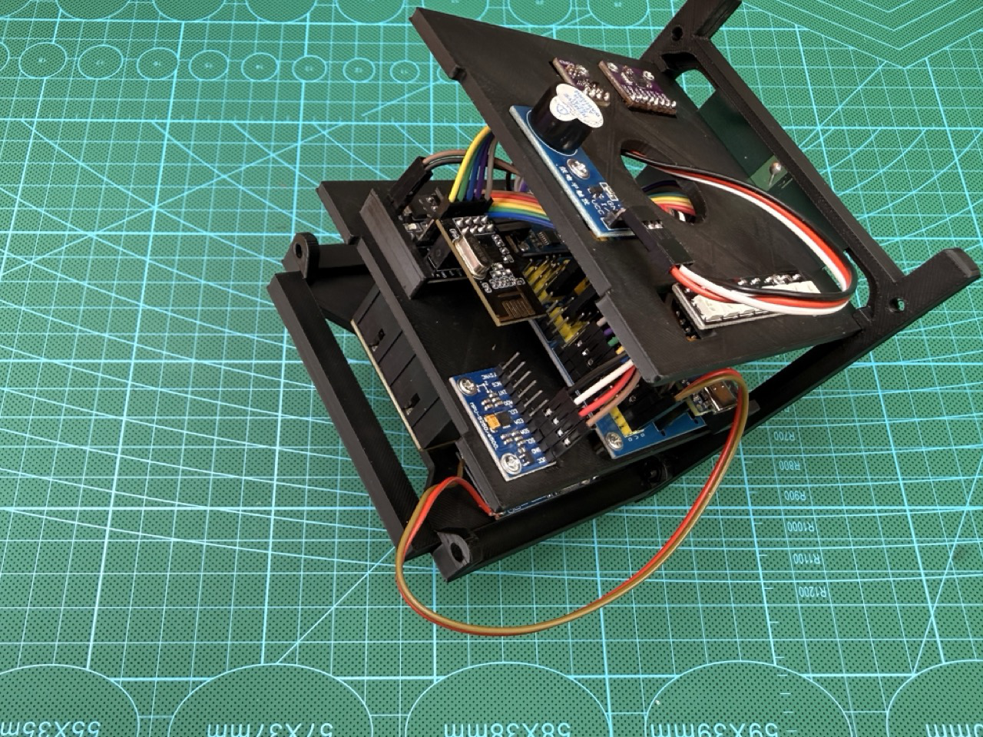
[picture p64: docs/wiki/source/_static/38.jpeg]
Шаг сборки 38


   Шаг 38.

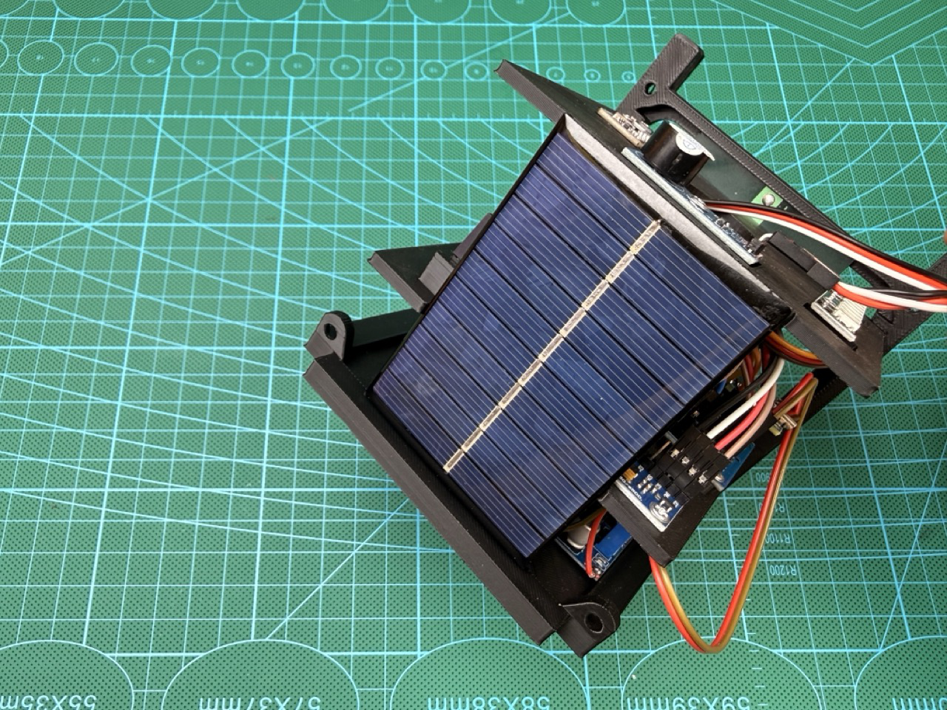
[picture p65: docs/wiki/source/_static/39.jpeg]
Шаг сборки 39


   Шаг 39.

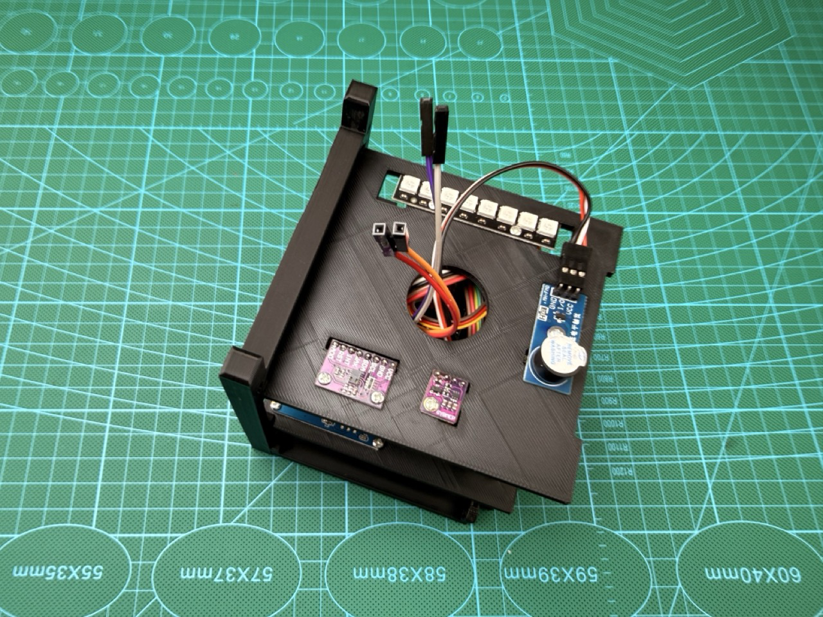
[picture p66: docs/wiki/source/_static/40.jpeg]
Шаг сборки 40


   Шаг 40.

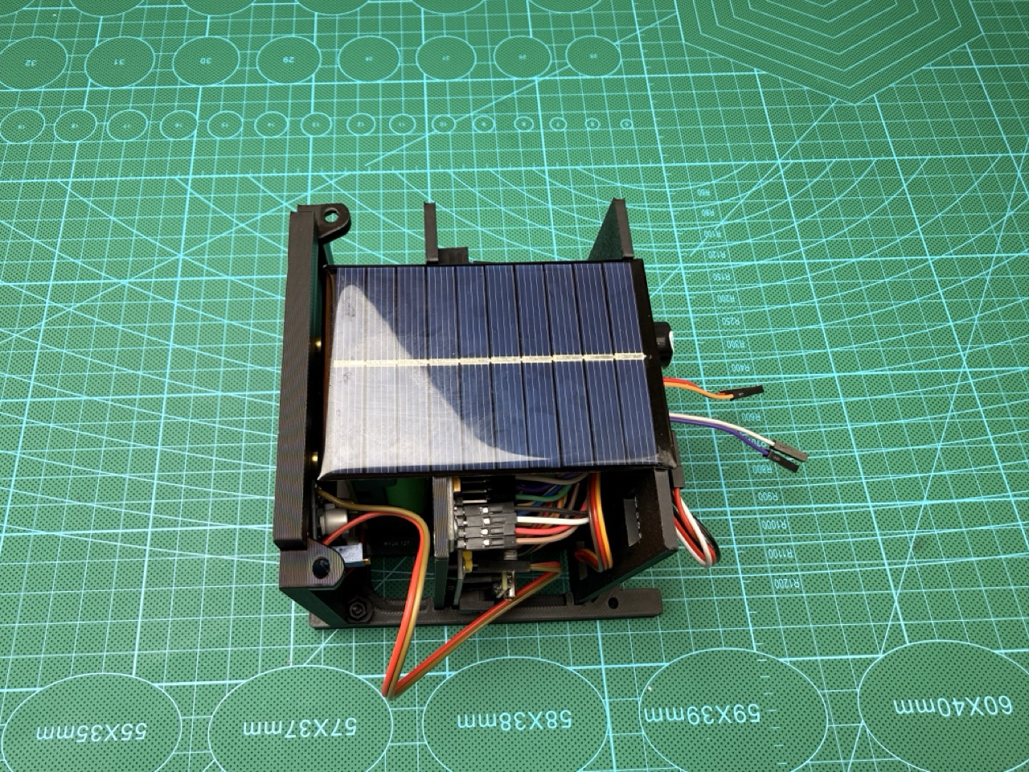
[picture p67: docs/wiki/source/_static/41.jpeg]
Шаг сборки 41


   Шаг 41.

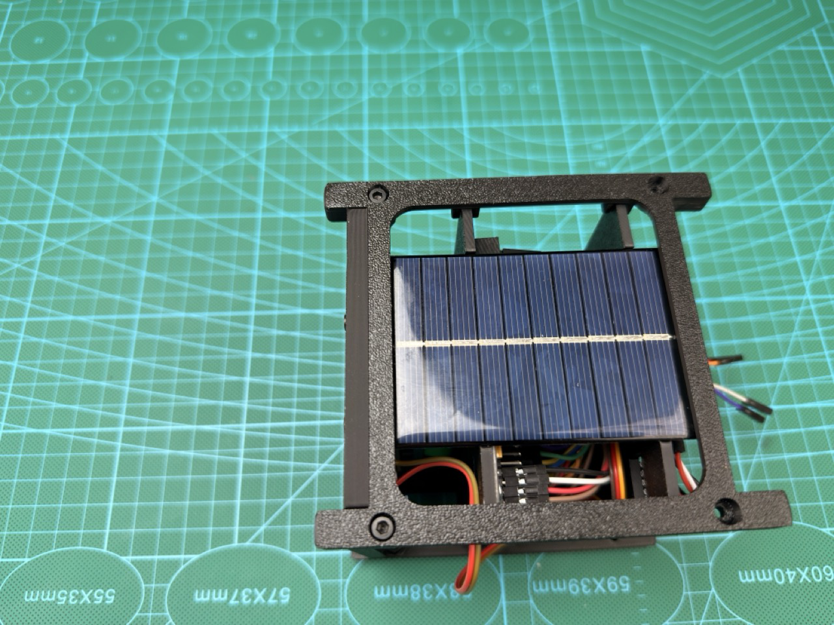
[picture p68: docs/wiki/source/_static/42.jpeg]
Шаг сборки 42


   Шаг 42.

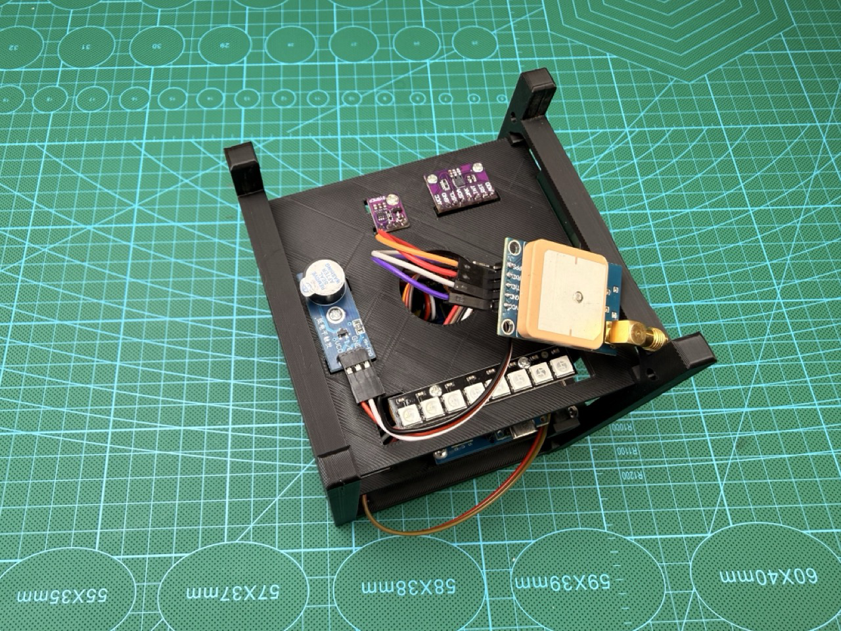
[picture p69: docs/wiki/source/_static/43.jpeg]
Шаг сборки 43


   Шаг 43.

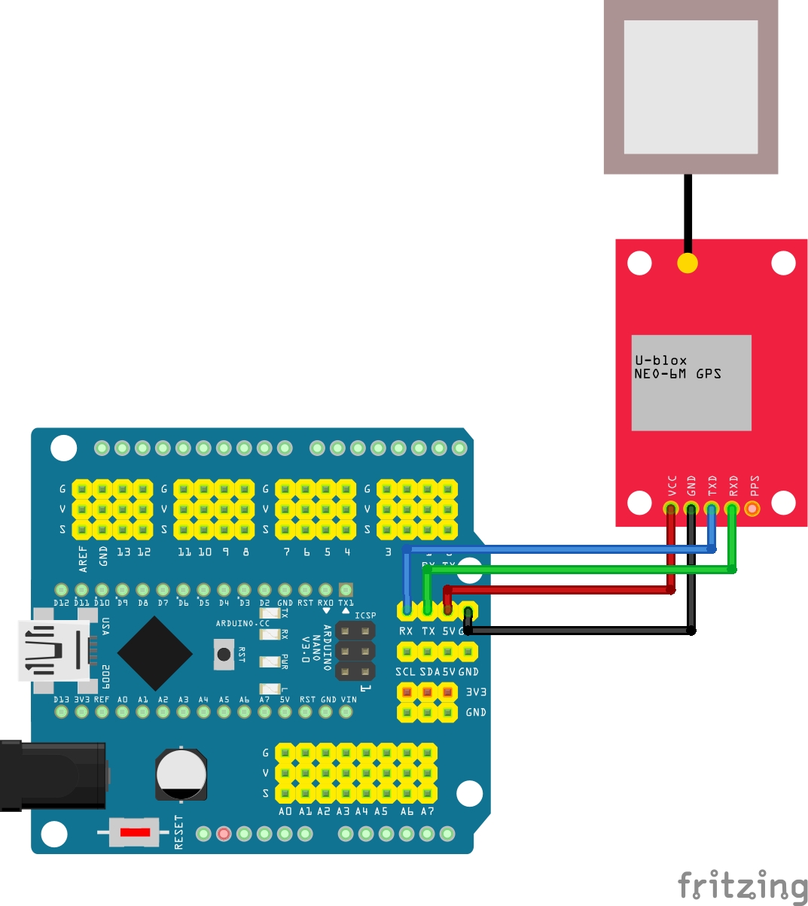
[picture p70: docs/wiki/source/_static/CubeSat-scheme-step-44.jpg]
Шаг сборки 44 — схема подключения


   Шаг 44. Схема подключения модулей (см. примечание выше).

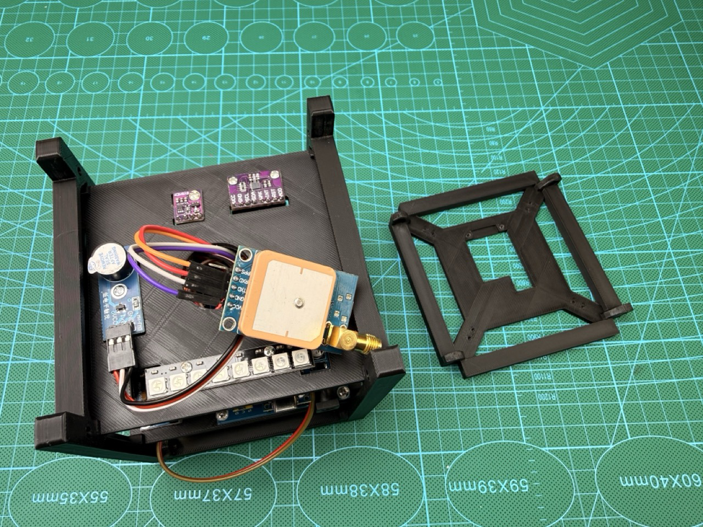
[picture p71: docs/wiki/source/_static/45.jpeg]
Шаг сборки 45


   Шаг 45.

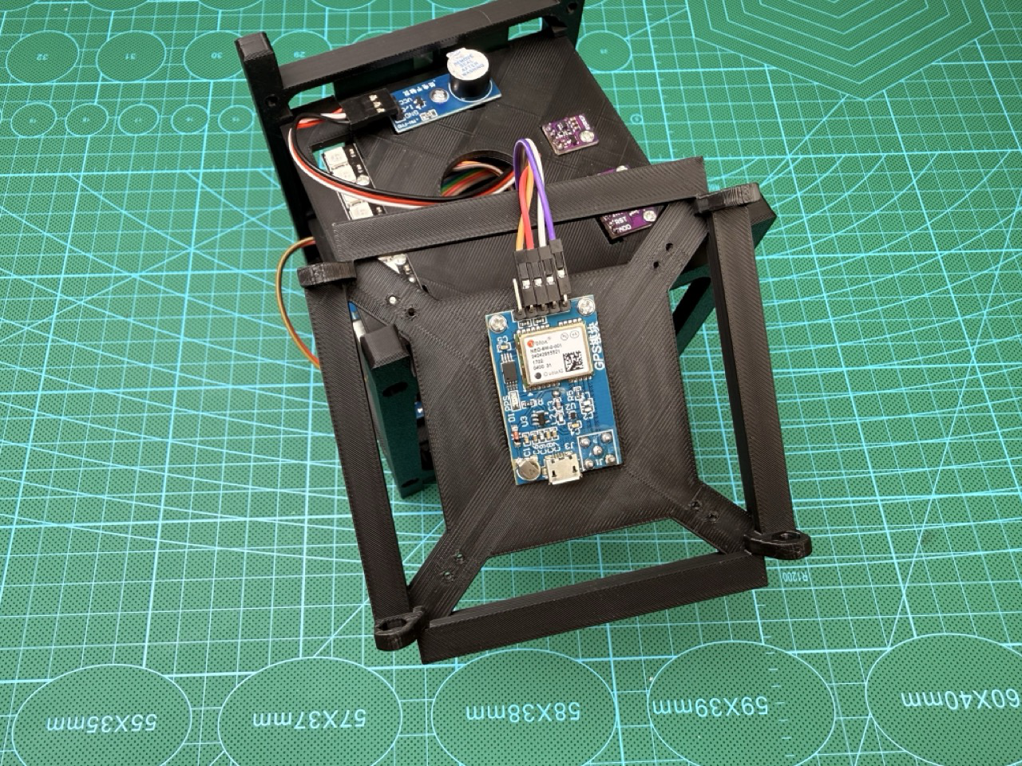
[picture p72: docs/wiki/source/_static/46.jpeg]
Шаг сборки 46


   Шаг 46.

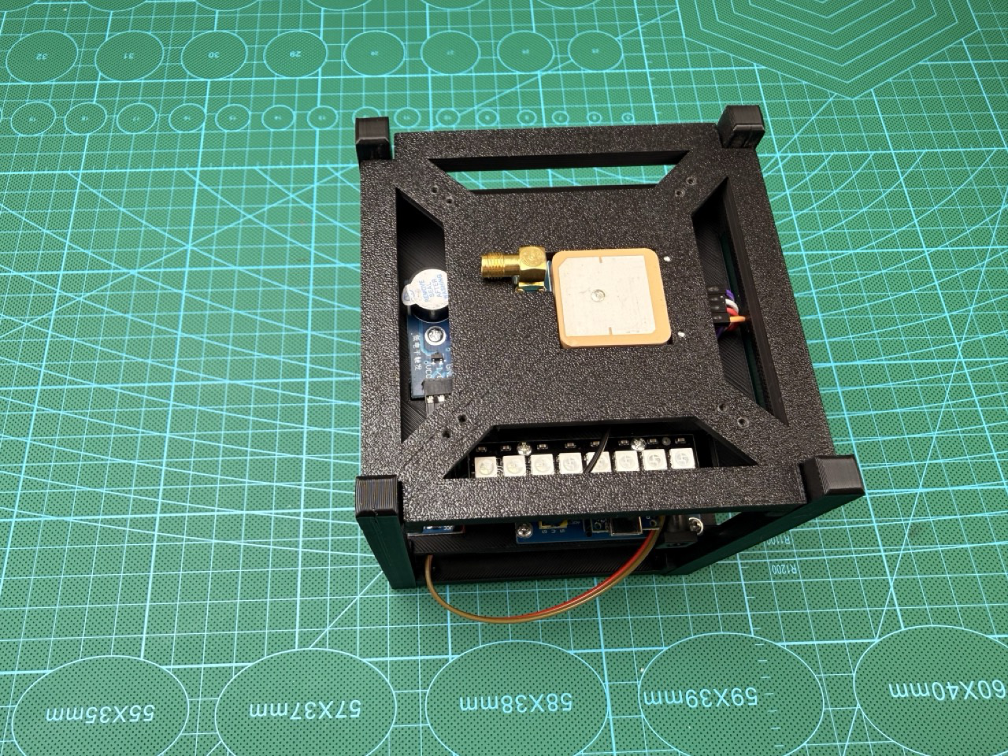
[picture p73: docs/wiki/source/_static/47.jpeg]
Шаг сборки 47


   Шаг 47.

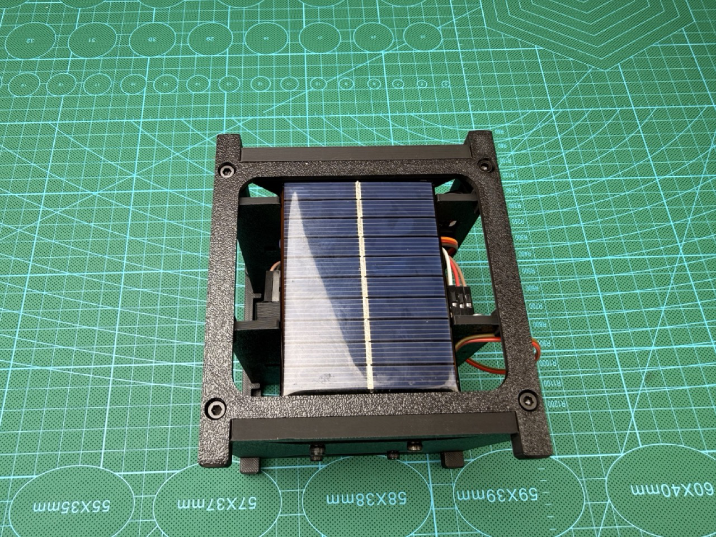
[picture p74: docs/wiki/source/_static/48.jpeg]
Шаг сборки 48


   Шаг 48.

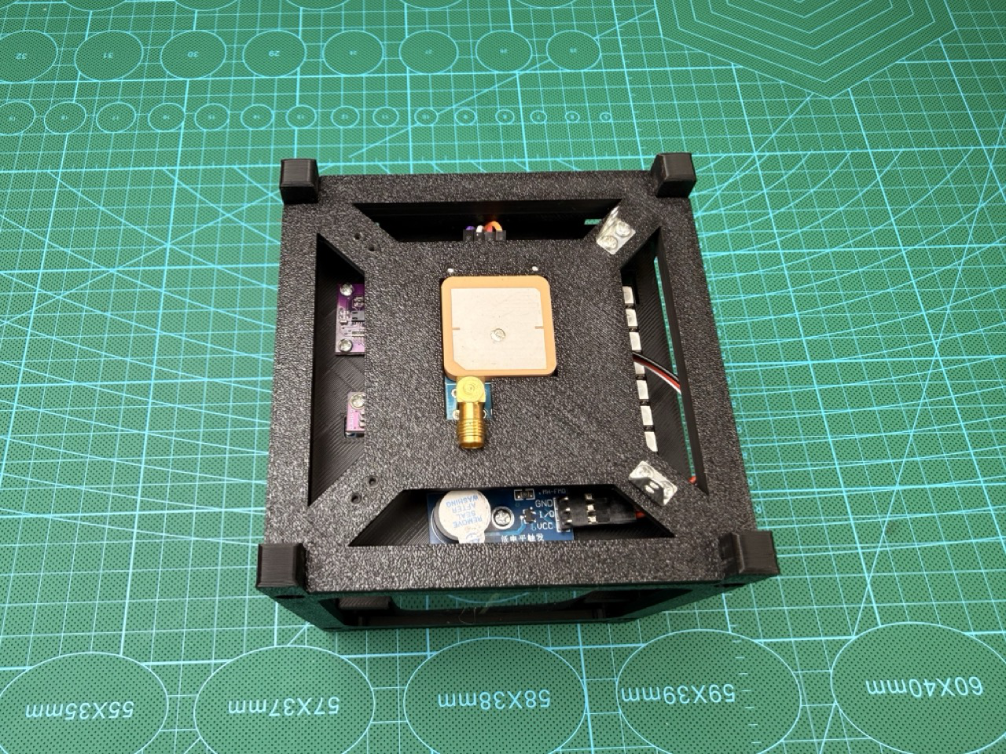
[picture p75: docs/wiki/source/_static/49.jpeg]
Шаг сборки 49


   Шаг 49.

Шаг сборки 50

   Шаг 50.

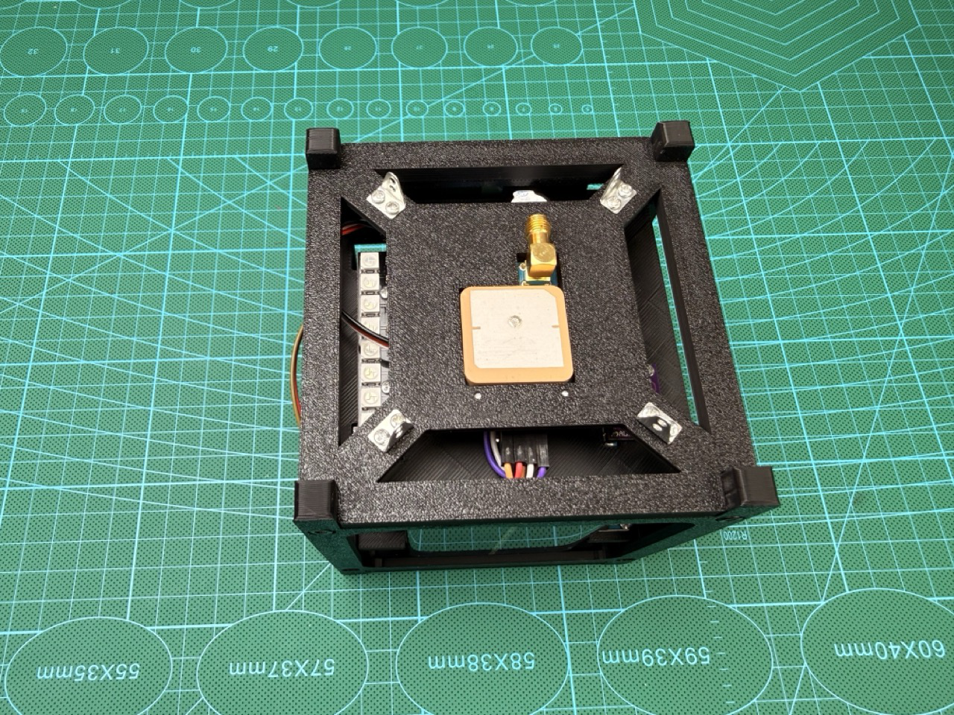
[picture p76: docs/wiki/source/_static/51.jpeg]
Шаг сборки 51


   Шаг 51.

Проверка после сборки
---------------------

- Все модули определяются программой диагностики.
- Потребление тока находится в допустимом диапазоне.
- Бортовой компьютер стабильно запускается и отвечает.
