Alashed/cubesat-wiki/(list of files, drawings)

Other design files:
CubeSat.fzz
