Alashed/cubesat-wiki/(commit log)

2026-04-28 Initialize CubeSat wiki with Sphinx docs and Pages CI/CD.
    Set up documentation structure, assets, and a GitHub Actions workflow to build and deploy the wiki to GitHub Pages on every push to main.
    Made-with: Cursor
    [CubeSat.fzz]
2026-04-28 Expand coding docs with real sketch includes and reorganized examples.
    Document module-by-module Arduino/ESP examples via literalinclude, update paths to new folder-per-sketch layout, add radio/base-station/full-mission code samples, and keep docs order aligned with the learning flow.
    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
    [CubeSat.fzz]
2026-04-30 Add full photo-based assembly guide sequence.
    Embed step-by-step assembly images 1 through 48 into the assembly documentation so the build process can be followed visually end-to-end.
    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
2026-05-08 Drop RTD config; enable copybutton and C++ highlighting in Sphinx.
    Consolidate publishing on GitHub Pages and improve the reading
    experience for Arduino sketches included via literalinclude.
2026-05-08 Insert wiring schemes at steps 26/35/44 and reorder photos.
    Add Fritzing schemes before assembly steps 26, 35 and 44; each scheme
    shows only the modules connected at that point of the instruction so
    the wiring stays readable. Renumber the trailing photos accordingly,
    swap two pairs that were out of order (15/16 and 27/28), and fix the
    off-by-one count in the section title.
2026-05-08 Re-orient photo for assembly step 34.
2026-05-08 Add Useful Links page with Fritzing scheme drive folder.
    Introduce a new top-level Useful Links section with a Schemes &
    Assembly subsection linking to the shared Fritzing source files used
    to build the wiring diagrams in the assembly guide.
2026-05-08 Add solar panels and replace chassis photo on the components page.
2026-05-08 Rework coding section: pinout table, accurate sketch behaviour, expected output.
    Treat the kit as already wired per main_full and stop telling students to
    re-plug pins for individual checks. coding-setup gains the canonical pin
    table, library list, baud rate convention (115200 vs 9600), and CH340 /
    Old Bootloader gotchas. Each module page now describes what its sketch
    actually does, shows the real Serial Monitor output, and lists concrete
    acceptance ranges. coding-mpu9250 now matches the sketch (magnetometer
    via AK8963 bypass, hardcoded 0x68 caveat). coding-gps explains why GPS
    sits on D0/RX0 and the disconnect-TX-during-upload workflow. coding-radio
    flags the 8 vs 32 byte payload mismatch b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
2026-05-08 Flesh out base station, full mission and diagnostics pages.
    coding-base-station now distinguishes itself from the full mission:
    no GPS or SD, ESP32 makes its own AP "tenderboy-base", students reach
    the JSON dashboard at 192.168.4.1. coding-full-mission documents the
    power-on self-test beep sequence, the 32-byte TboyAirPkt layout, all
    24 columns of TBOY.CSV, the WS2812 colour scheme by HDOP, and the
    beep schedule. coding-diagnostics is reorganised as symptom -> cause
    -> fix tables grouped by subsystem (uploading, power, I2C, SPI/SD,
    radio, GPS, LED/buzzer, full mission). The code-examples landing
    page gets a chapter overview table with rough time budgets.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
2026-05-08 Drop the 470 ohm MISO resistor notes; the SD modules ship with it onboard.
2026-05-08 Drop the WS2812 series resistor note; the LED strip ships with it onboard.
